chankrrn/WRO-FE-YBR-SUNFLOWER/v-photos/README.md

# Vehicle Photographs

This gallery will document the current vehicle from all required angles. **[TODO]** Add photographs of the completed redesigned vehicle and record the hardware revision/date so they match the engineering journal. Do not substitute Version 1.0 photographs for the new vehicle without labeling them.

## Standard views

| Front | Right | Rear |
|---|---|---|
| **[TODO]** Front-view photo | **[TODO]** Right-side photo | **[TODO]** Rear-view photo |

| Left | Top | Bottom |
|---|---|---|
| **[TODO]** Left-side photo | **[TODO]** Top-view photo | **[TODO]** Bottom-view photo |

## Additional views

| Right-front | Right-rear | Left-front | Left-rear |
|---|---|---|---|
| **[TODO]** Photo | **[TODO]** Photo | **[TODO]** Photo | **[TODO]** Photo |

## Components and construction details

- **[TODO]** Add annotated close-ups of the drivetrain, steering mechanism, electronics mounting, connectors, sensor mounts, and cable routing.
- **[TODO]** Provide a caption for each image: viewpoint, vehicle revision, date, and the design feature illustrated.

See the [Mobility and mechanical design](../journal/mech.md) and [Power and system architecture journal](../journal/elec.md) for component specifications, construction, and testing evidence.

[Back to project overview](../README.md)
