chankrrn/WRO-FE-YBR-SUNFLOWER/t-photos/README.md

# Team Photographs

Official YBR-SUNFLOWER team photograph

## Team and responsibilities

| Member | Primary responsibility | Supporting responsibilities |
|---|---|---|
| **Peradon Nimsongprasert (Tun)** | Robot construction and software development | Testing, debugging, and optimization |
| **Chanakarn Yimsakul (Indy)** | Engineering documentation and technical writing | Development records and software support |
| **Thanphisit Sakulvitulthai (Peach)** | Hardware development and electrical systems | Assembly, tests, and documentation |

## Photo collection

- **[TODO]** Add workshop, assembly, calibration, and testing photographs with dates and short captions.
- **[TODO]** Add updated team photos if needed, with filenames and appropriate credits.

[Back to project overview](../README.md)
