chankrrn/WRO-FE-YBR-SUNFLOWER/engineering_journal/visualization/16_motor_spec_points.png

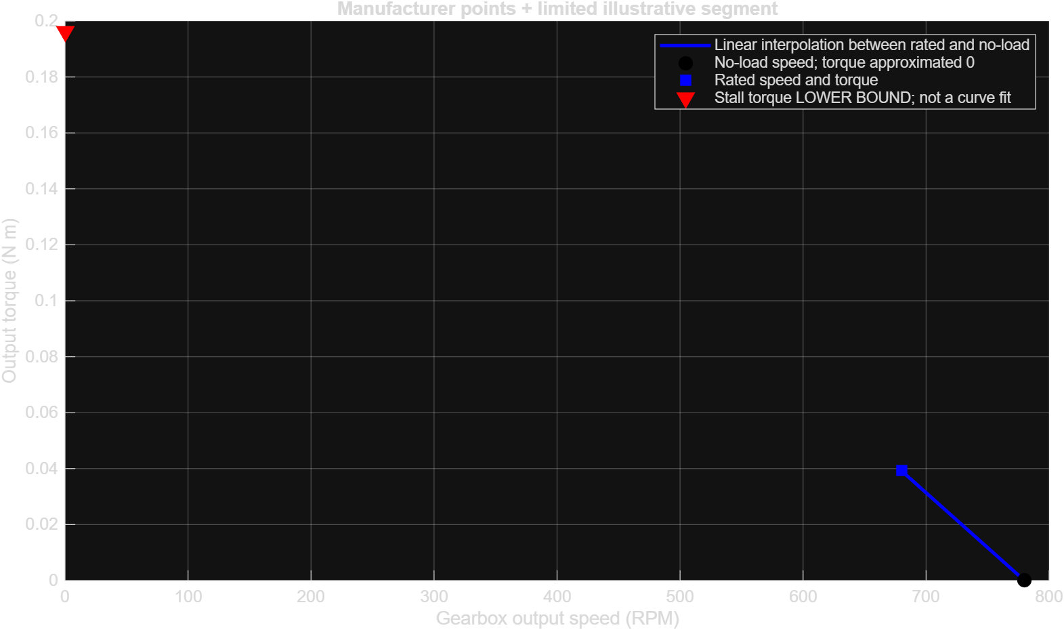
engineering_journal/visualization/16_motor_spec_points.png
