chankrrn/WRO-FE-YBR-SUNFLOWER/src/Raspberrypi/fov_check.png

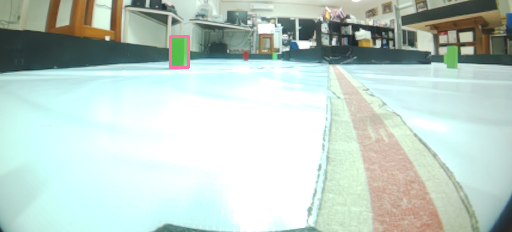
src/Raspberrypi/fov_check.png
