chankrrn/WRO-FE-YBR-SUNFLOWER/models/CAD/cam_plate.stl

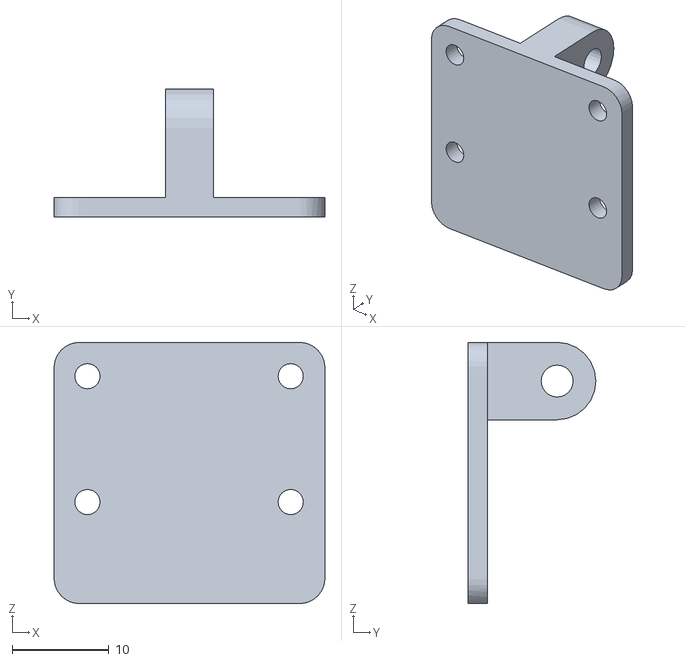
[picture p8: CAD file, 2026-11-12]
models/CAD/cam_plate.stl
28.0 x 13.2 x 27.0
