chankrrn/WRO-FE-YBR-SUNFLOWER/models/CAD/steering/steering_rack.stl

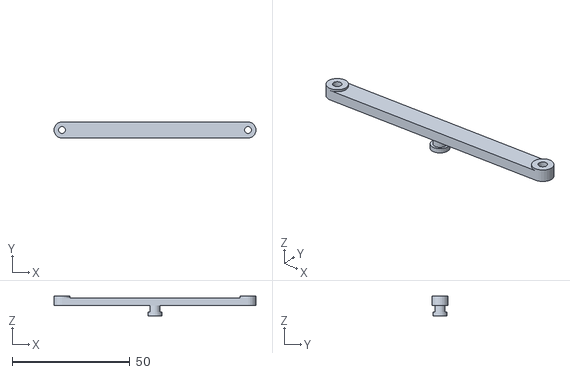
[picture p9: CAD file, 2026-11-12]
models/CAD/steering/steering_rack.stl
85.7 x 6.83 x 8.30
