chankrrn/WRO-FE-YBR-SUNFLOWER/models/CAD/servo_base.stl

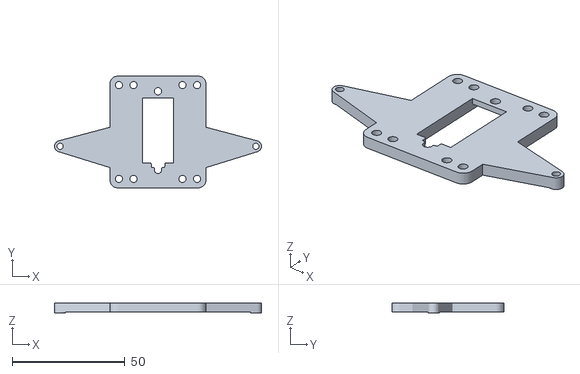
[picture p10: CAD file, 2026-11-12]
models/CAD/servo_base.stl
92.0 x 49.7 x 4.30
