chankrrn/WRO-FE-YBR-SUNFLOWER/models/CAD/Mid_axle_sleeve.stl

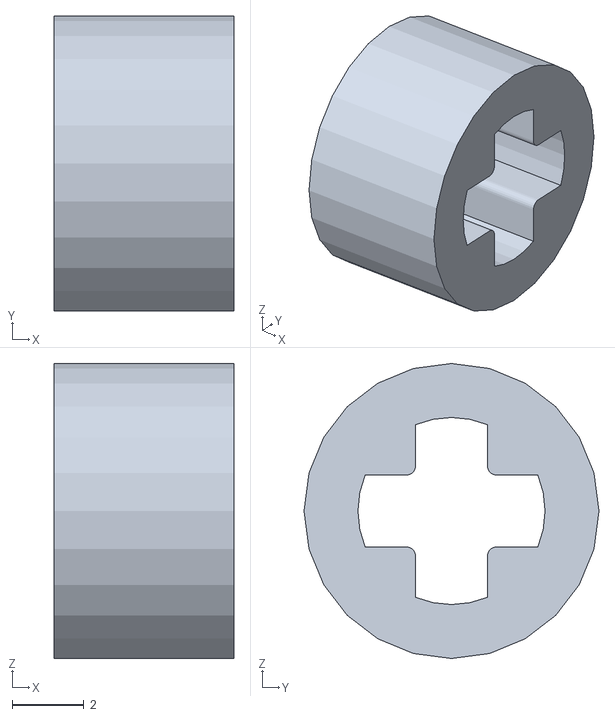
[picture p11: CAD file, 2026-11-12]
models/CAD/Mid_axle_sleeve.stl
5.00 x 8.20 x 8.20
