chankrrn/WRO-FE-YBR-SUNFLOWER/models/CAD/top_buck.stl

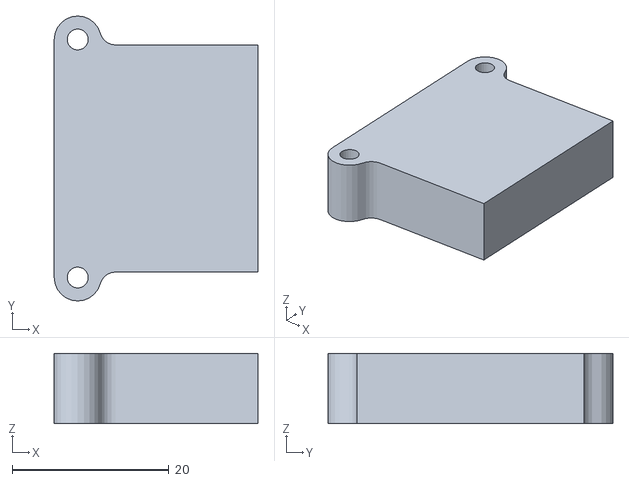
[picture p12: CAD file, 2026-11-12]
models/CAD/top_buck.stl
26.0 x 36.4 x 9.00
