chankrrn/WRO-FE-YBR-SUNFLOWER/models/CAD/elec_base.stl

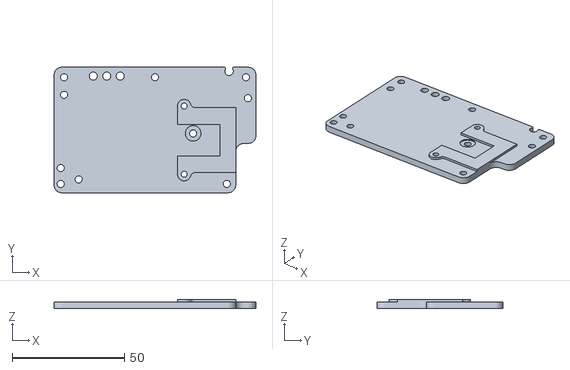
[picture p13: CAD file, 2026-11-12]
models/CAD/elec_base.stl
90.0 x 56.0 x 4.00
