chankrrn/WRO-FE-YBR-SUNFLOWER/models/CAD/cap.stl

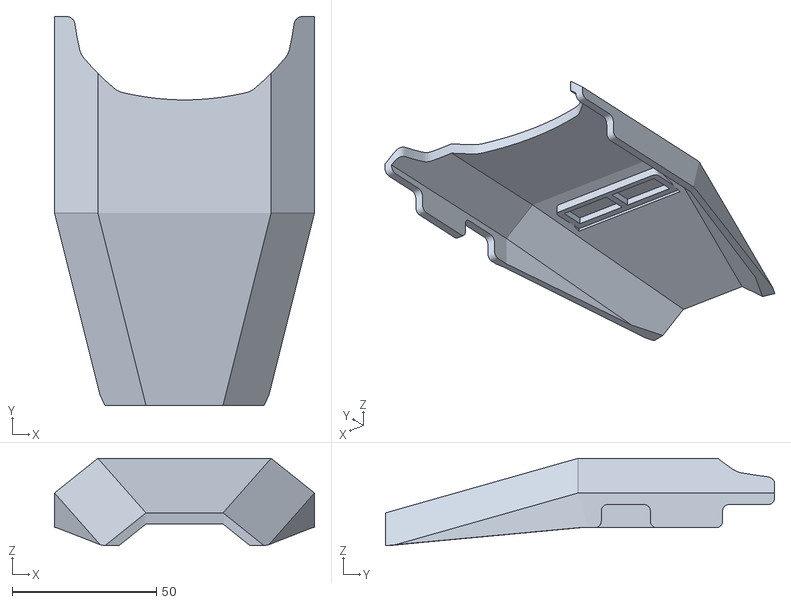
[picture p14: CAD file, 2026-11-12]
models/CAD/cap.stl
90.0 x 134.7 x 30.3
