chankrrn/WRO-FE-YBR-SUNFLOWER/models/CAD/IMU_plate.stl

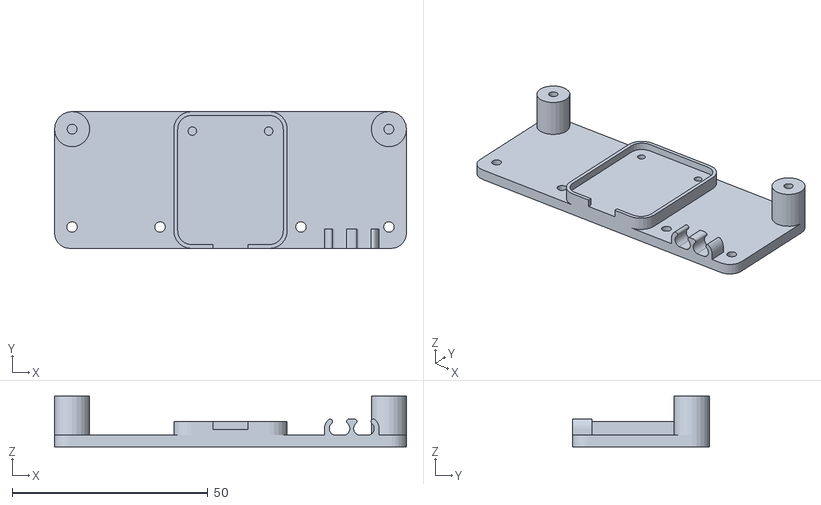
[picture p15: CAD file, 2026-11-12]
models/CAD/IMU_plate.stl
90.0 x 35.0 x 13.0
