chankrrn/WRO-FE-YBR-SUNFLOWER/(list of files, cad)

Other CAD files:
models/CAD/bottom_buck.stl
