chankrrn/WRO-FE-YBR-SUNFLOWER/history/README.md

# Competition Record 

## Our Team (Robot Version 1.0)

YBR-SUNFLOWER, representing **Yothinburana School**, placed **1st** in the **WRO Thailand 2026 Future Engineers National Final**, held on **3–4 September 2026**.

<p align="center">
  
</p>

## Senior Team

`2010 — First International Round Achievement`

Our team made its international debut at the World Robot Olympiad (WRO) in 2010, achieving 3rd place (Second Runner-Up).

<p align="center">
  
</p>

`2011 — Second International Round Achievement`

In our second appearance at the WRO international round in 2011, our team achieved 1st place (Champion), marking a significant milestone in our competition history.  

<p align="center">
  
</p>

`20XX — Latest International Round Achievement`

<p align="center">
  
</p>

Currently in 2026, we are part of the **YB Robot Team**. Our senior helped bring this team name to global recognition, and we aim to continue the legacy and make them proud.

<hr>
