chankrrn/WRO-FE-YBR-SUNFLOWER/engineering_journal/visualization/11_resistance_load_sweep.png

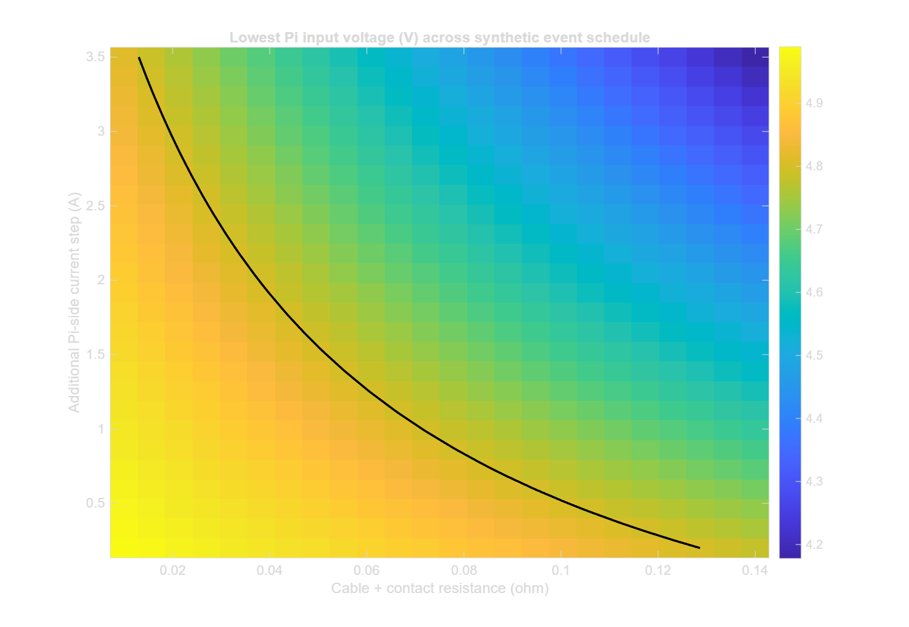
engineering_journal/visualization/11_resistance_load_sweep.png
