chankrrn/WRO-FE-YBR-SUNFLOWER/engineering_journal/visualization/12_turning_radius_vs_steering.png

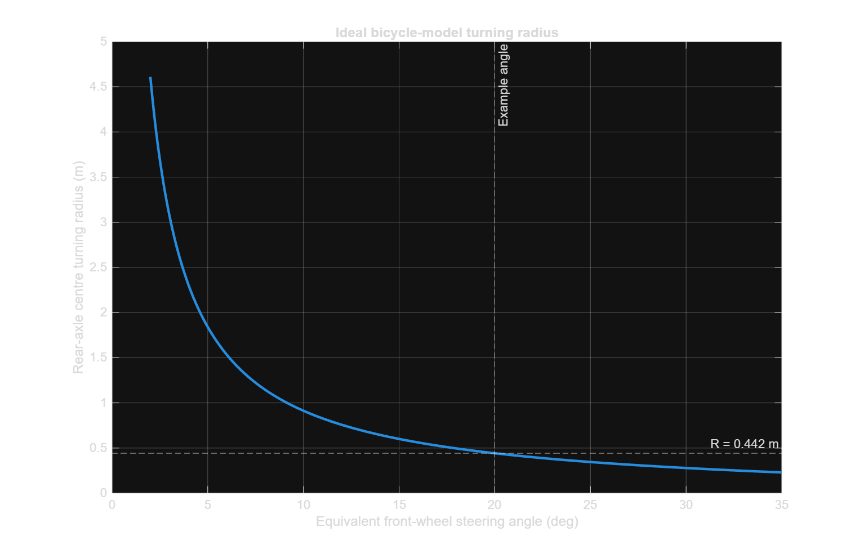
engineering_journal/visualization/12_turning_radius_vs_steering.png
