chankrrn/WRO-FE-YBR-SUNFLOWER/engineering_journal/visualization/25_cg_height_tipping_sensitivity.png

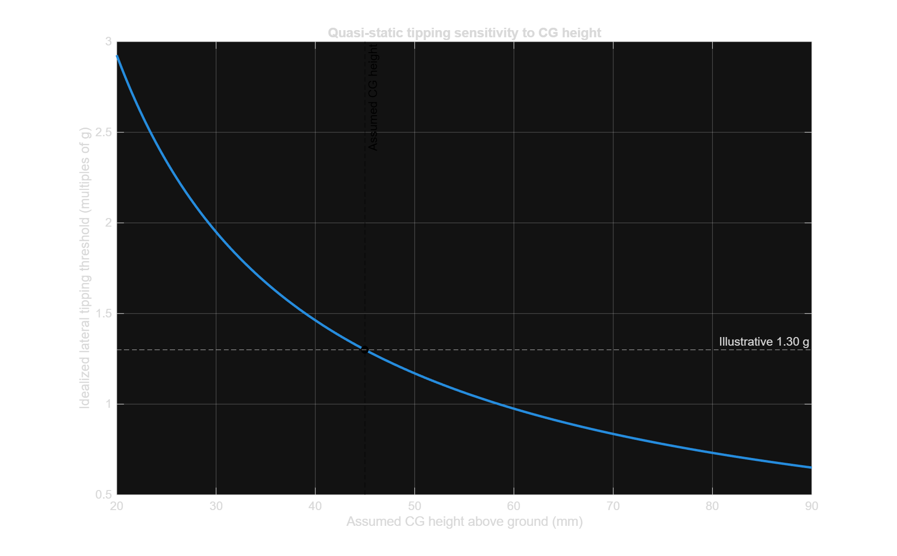
engineering_journal/visualization/25_cg_height_tipping_sensitivity.png
