chankrrn/WRO-FE-YBR-SUNFLOWER/history/ver01.jpg

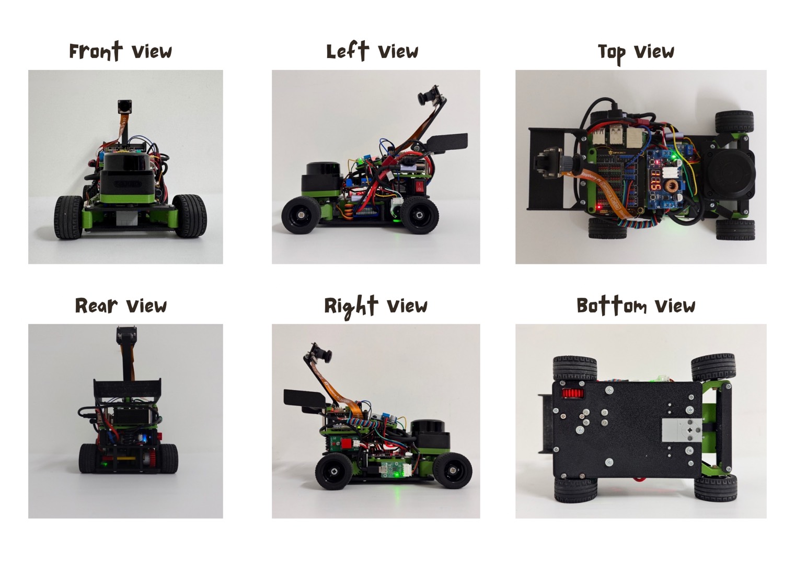
history/ver01.jpg
