chankrrn/WRO-FE-YBR-SUNFLOWER/journal/visualization/02_input_range_screen.png

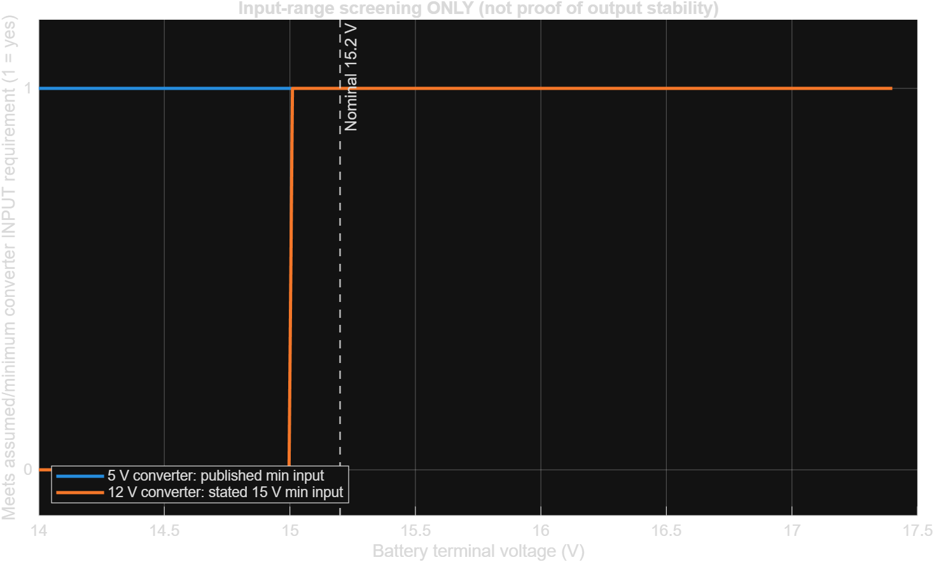
journal/visualization/02_input_range_screen.png
