chankrrn/WRO-FE-YBR-SUNFLOWER/journal/visualization/03_estimated_input_current.png

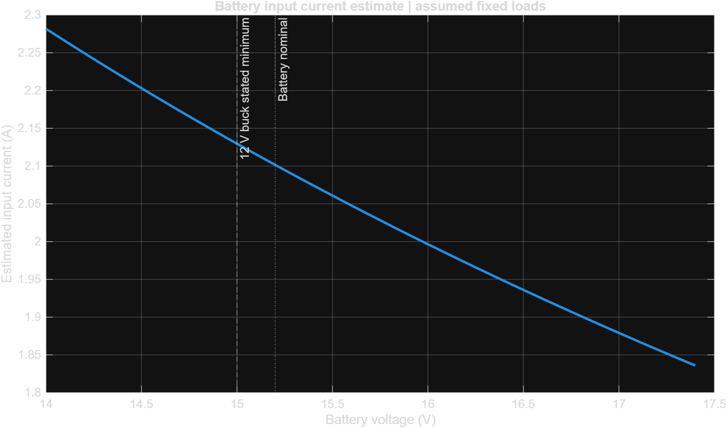
journal/visualization/03_estimated_input_current.png
