chankrrn/WRO-FE-YBR-SUNFLOWER/journal/visualization/04_assumed_voltage_vs_soc.png

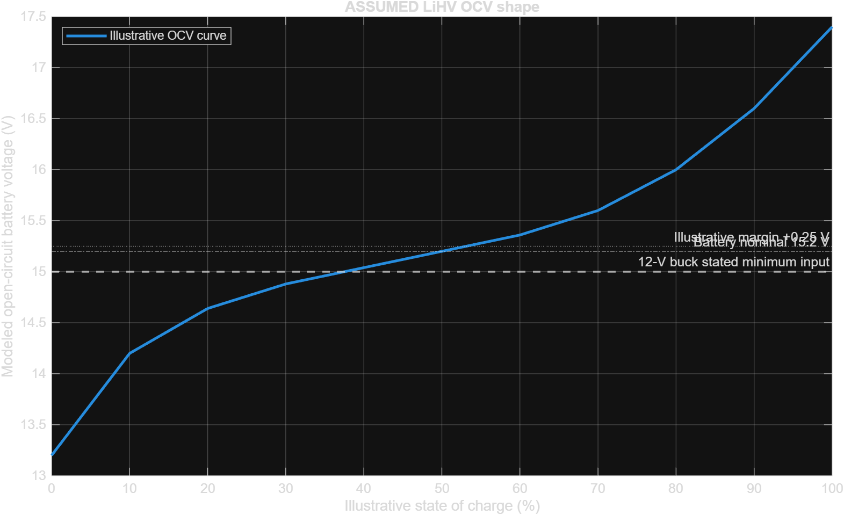
journal/visualization/04_assumed_voltage_vs_soc.png
