chankrrn/WRO-FE-YBR-SUNFLOWER/journal/visualization/05_voltage_vs_time_scenarios.png

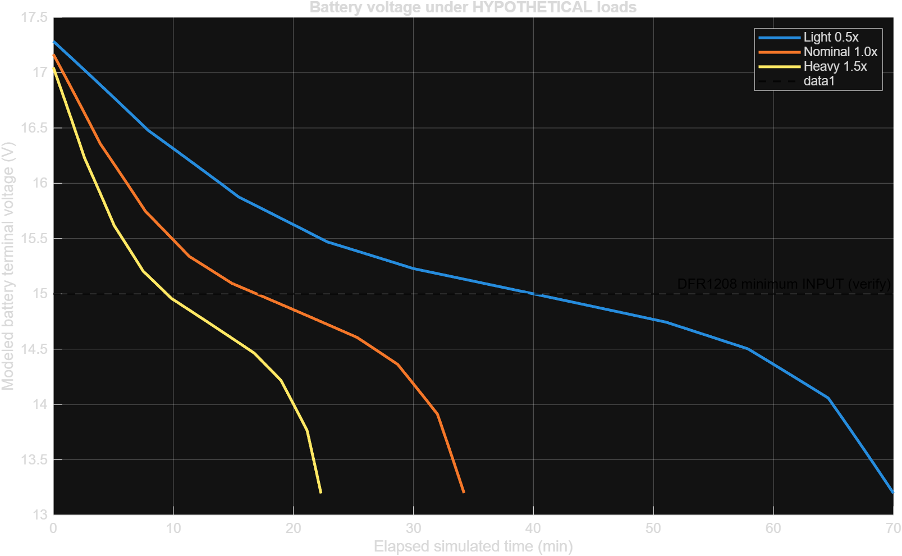
journal/visualization/05_voltage_vs_time_scenarios.png
