chankrrn/WRO-FE-YBR-SUNFLOWER/journal/visualization/06_soc_and_current.png

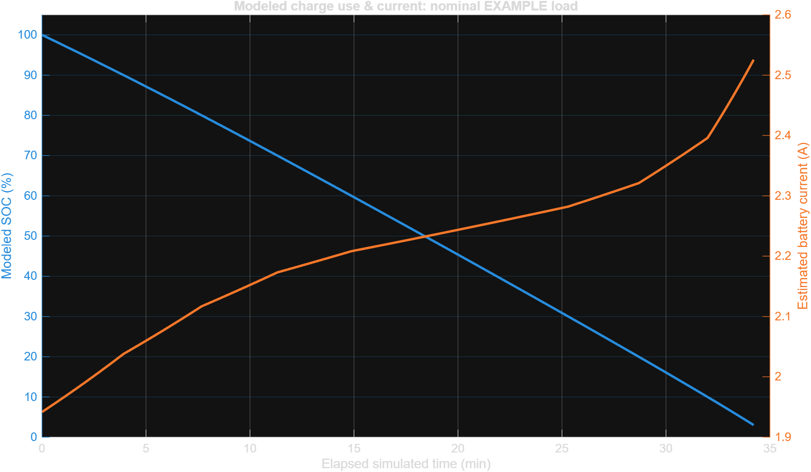
journal/visualization/06_soc_and_current.png
