chankrrn/WRO-FE-YBR-SUNFLOWER/journal/visualization/08_transient_timeline.png

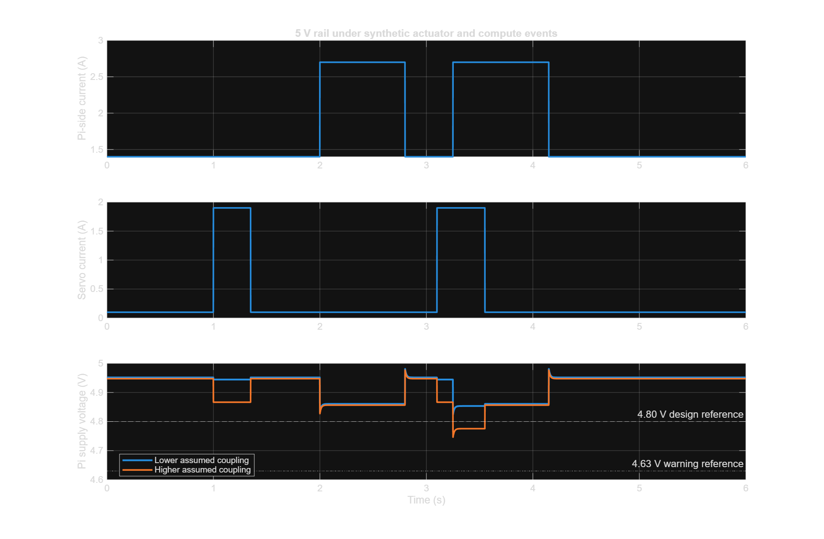
journal/visualization/08_transient_timeline.png
