chankrrn/WRO-FE-YBR-SUNFLOWER/journal/visualization/13_ackermann_angles.png

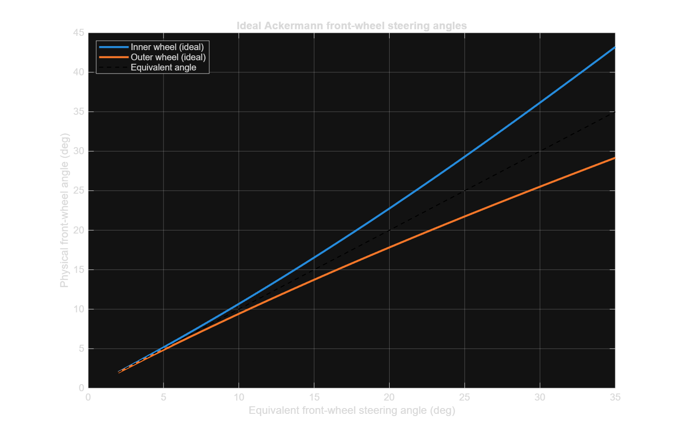
journal/visualization/13_ackermann_angles.png
