chankrrn/WRO-FE-YBR-SUNFLOWER/journal/visualization/14_ideal_wheel_paths.png

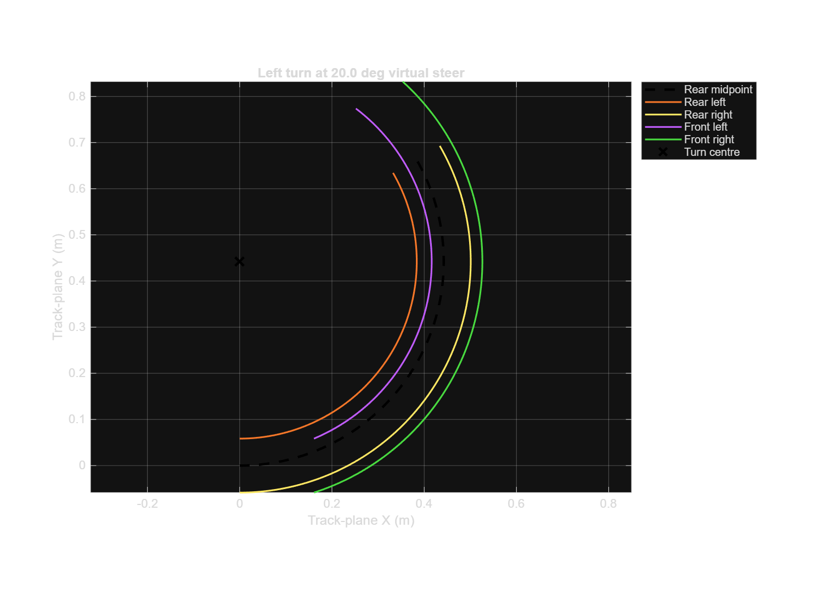
journal/visualization/14_ideal_wheel_paths.png
