chankrrn/WRO-FE-YBR-SUNFLOWER/journal/visualization/18_tractive_force_sensitivity.png

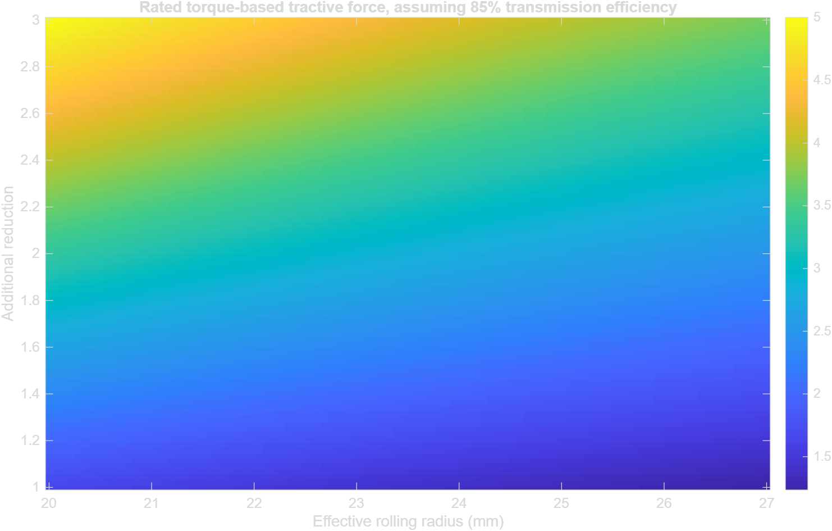
journal/visualization/18_tractive_force_sensitivity.png
