chankrrn/WRO-FE-YBR-SUNFLOWER/journal/visualization/20_shaft_and_wheel_response.png

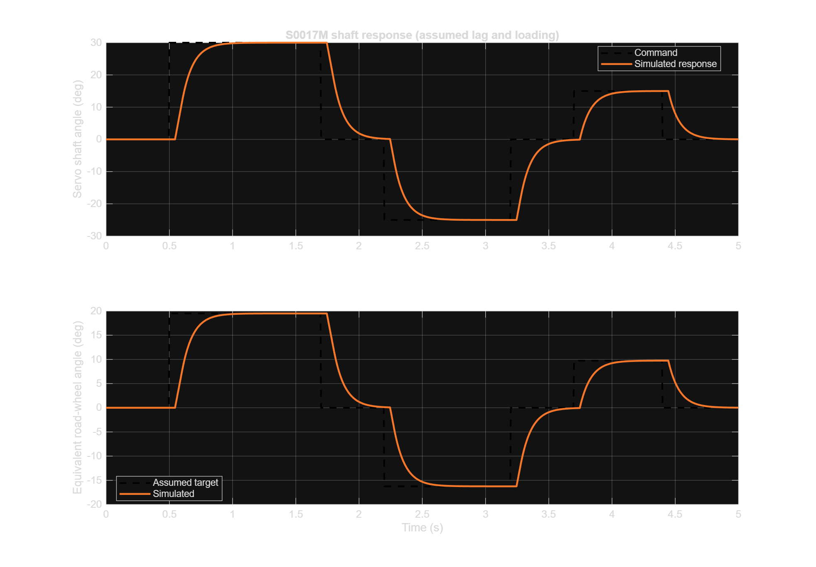
journal/visualization/20_shaft_and_wheel_response.png
