chankrrn/WRO-FE-YBR-SUNFLOWER/journal/visualization/21_scenario_comparison.png

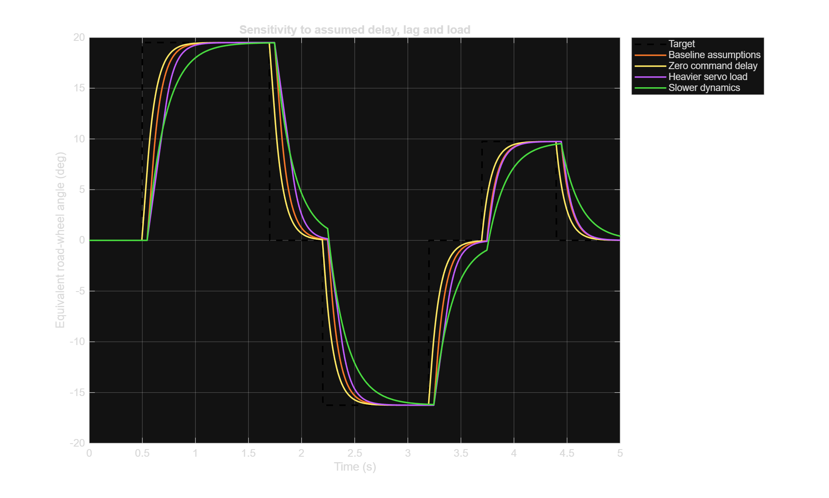
journal/visualization/21_scenario_comparison.png
