chankrrn/WRO-FE-YBR-SUNFLOWER/journal/visualization/22_steering_error.png

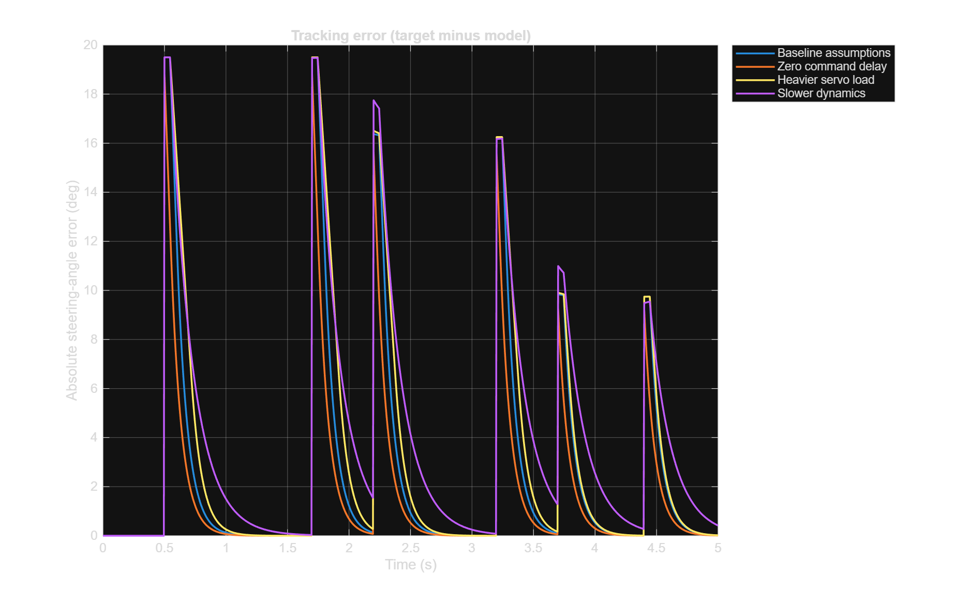
journal/visualization/22_steering_error.png
