chankrrn/WRO-FE-YBR-SUNFLOWER/journal/visualization/23_yaw_rate_effect.png

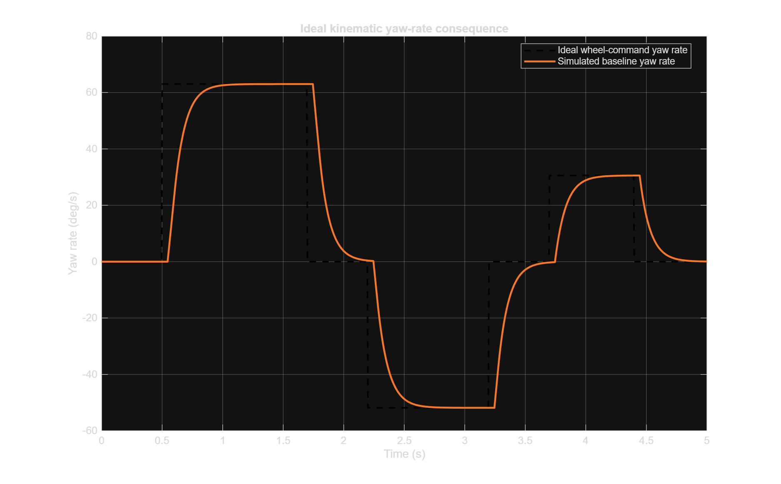
journal/visualization/23_yaw_rate_effect.png
