chankrrn/WRO-FE-YBR-SUNFLOWER/journal/visualization/24_axle_load_distribution.png

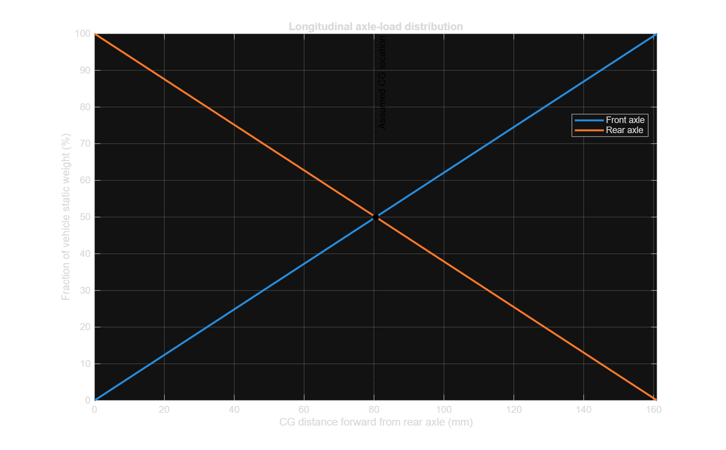
journal/visualization/24_axle_load_distribution.png
