chankrrn/WRO-FE-YBR-SUNFLOWER/journal/visualization/26_swept_body_paths.png

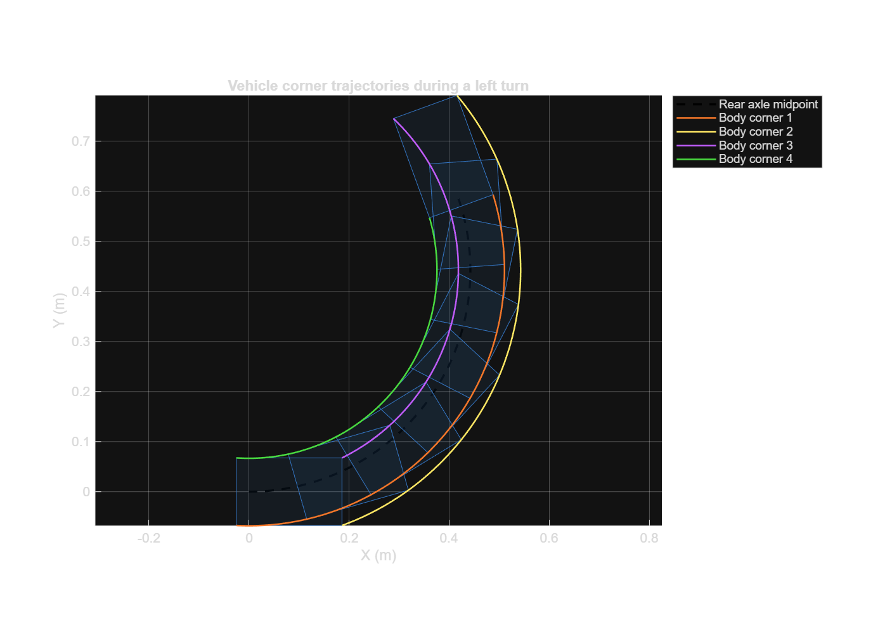
journal/visualization/26_swept_body_paths.png
