chankrrn/WRO-FE-YBR-SUNFLOWER/journal/visualization/27_turn_envelope_vs_steering.png

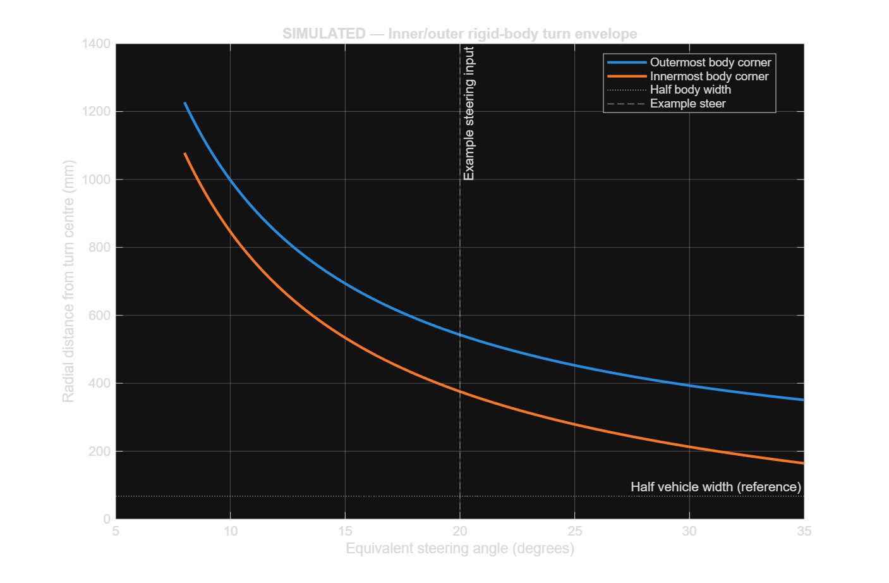
journal/visualization/27_turn_envelope_vs_steering.png
