chankrrn/WRO-FE-YBR-SUNFLOWER/journal/visualization/29_pure_pursuit_tracking.png

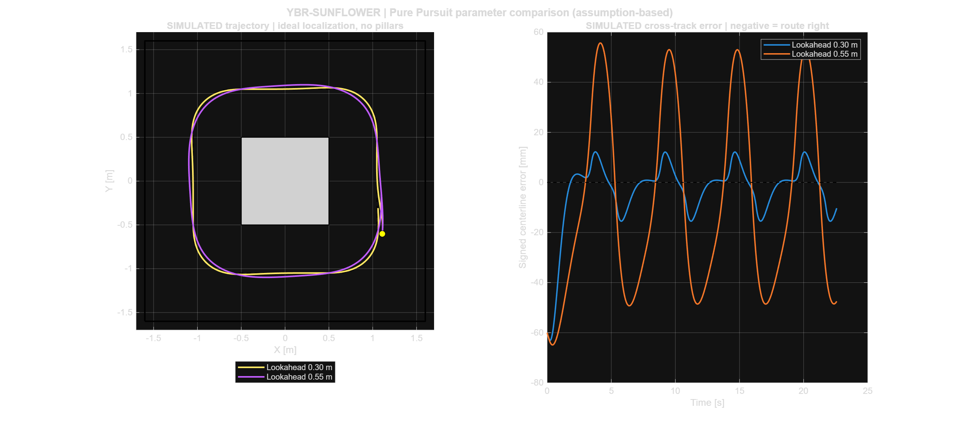
journal/visualization/29_pure_pursuit_tracking.png
