chankrrn/WRO-FE-YBR-SUNFLOWER/schemes/schematic_diagram.pdf

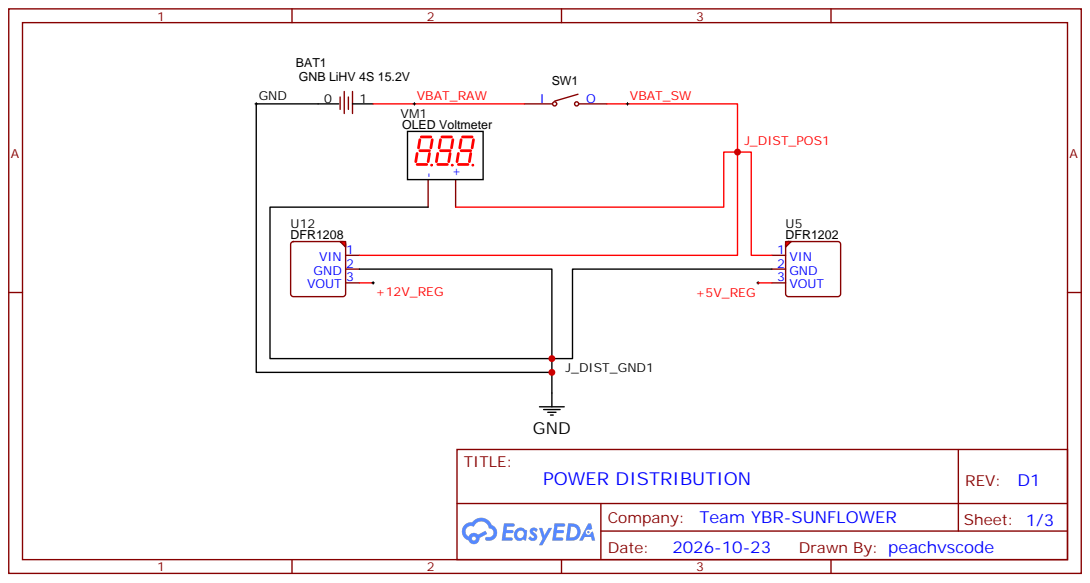
[picture p74: page 1]

Company: Team YBR-SUNFLOWER

A | A
B | B
C | C

### TITLE:

MAIN CONTROLLER & HAT INTERFACES | REV: D1
| Sheet: 2/3

## Company: Team YBR-SUNFLOWER

U2 DFR0592 DC Motor Driver HAT

I2C_SDA 1

I2C_SCL 2

HAT_5V 3

GND 4

VM_12V 5

VM_GND 6

M1- 7

M1+ 8

E1B 9

E1A 10

E1- 11

E1+ 12

U3 | DFR0604 IO Expansion HAT

I2C_SDA 1

I2C_SCL 2

HAT_5V 3

GND 4

GPIO16 5

UART_TX 6

UART_RX 7

SERVO_VP 8

IIC_D 9

IIC_C 10

IIC_+ 11

IIC_- 12

D16_D 13

D16_+ 14

D16_- 15

PWM3_P 16

PWM3_+ 17

PWM3_- 18

UART_R 19

UART_T 20

UART_- 21

RPI1 | Raspberry Pi 5
3.3V 1 | 5V 2
GPIO2 3 | 5V 4
GPIO3 5 | GND 6
GPIO4 7 | GPIO14 8
GND 9 | GPIO15 10
GPIO17 11 | GPIO18 12
GPIO27 13 | GND 14
GPIO22 15 | GPIO23 16
3.3V 17 | GPIO24 18
GPIO10 19 | GND 20
GPIO9 21 | GPIO25 22
GPIO11 23 | GPIO8 24
GND 25 | GPIO7 26
GPIO0 27 | GPIO1 28
GPIO5 29 | GND 30
GPIO6 31 | GPIO12 32
GPIO13 33 | GND 34
GPIO19 35 | GPIO16 36
GPIO26 37 | GPIO20 38
GND 39 | GPIO21 40

I2C_SCL

I2C_SCL

I2C_SDA

I2C_SDA

I2C_SCL

GND

+12V_REG

External motor supply: 12 V nominal

I2C_SDA

I2C_SCL

BTN_D16

BTN_D16

BTN_D16

PI_UART_TX

PI_UART_TX

PI_UART_TX

PI_UART_RX

PI_UART_RX
PI_UART_RX

PI_3V3

PI_3V3

PI_3V3

PI_3V3

PWM_STEER

SERVO_V+

GND

MOTOR_M1_NEG

MOTOR_M1_POS

ENC_E1B

ENC_E1A

ENC_E1_GND

ENC_E1_VCC

I2C_SDA

PI_5V
PI_5V
GND

GND

PI_5V

PI_5V

GND

GND

GND

GND

DC MOTOR & ENCODER | STEERING SERVO & USER INTERFACE

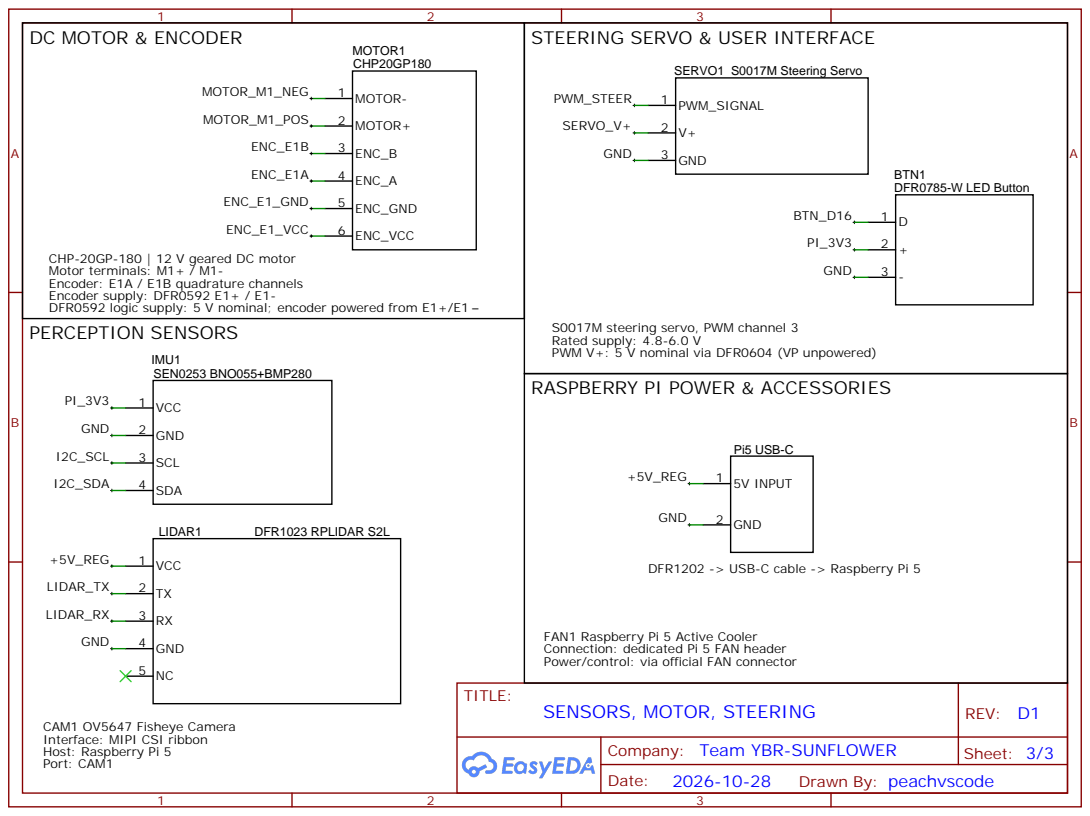
[picture p75: page 3]

CHP-20GP-180 | 12 V geared DC motor
Motor terminals: M1+ / M1-
Encoder: E1A / E1B quadrature channels
Encoder supply: DFR0592 E1+ / E1-
DFR0592 logic supply: 5 V nominal; encoder powered from E1+/E1
PERCEPTION SENSORS

S0017M steering servo, PWM channel 3
Rated supply: 4.8-6.0 V
PWM V+: 5 V nominal via DFR0604 (VP unpowered)
RASPBERRY PI POWER & ACCESSORIES

DFR1202 -> USB-C cable -> Raspberry Pi 5

FAN1 Raspberry Pi 5 Active Cooler
Connection: dedicated Pi 5 FAN header
Power/control: via official FAN connector

CAM1 OV5647 Fisheye Camera
Interface: MIPI CSI ribbon
Host: Raspberry Pi 5
Port: CAM1

Company: Team YBR-SUNFLOWER
