chankrrn/WRO-FE-YBR-SUNFLOWER/src/Raspberrypi/camera_manager.py

try:
    from picamera2 import Picamera2
except ImportError as exc:
    # The stub only exists so hsv_adjuster can be run off-Pi. On the Pi this
    # branch means the interpreter cannot see the system picamera2 - almost
    # always a venv built without --system-site-packages - and every frame
    # would silently come back empty. Say so instead of failing later with an
    # unrelated AttributeError deep inside configure_camera().
    print(f"WARNING: picamera2 unavailable ({exc}); falling back to the "
          f"fake_picamera2 stub - NO real frames will be captured.")
    from utils.fake_picamera2 import Picamera2
import time
from utils.image_transform_utils import ImageTransformUtils
from utils.image_transform_utils import ImageColorUtils
import cv2
import numpy as np
from utils.enums import Color
from utils.image_drawing_utils import ImageDrawingUtils
import math
import os
from utils.video.video_counter import VideoCounter
from classes.image_algoriths import ImageAlgorithms
from classes.context_manager import ContextManager

# Auto-exposure stays ON; this only shifts the brightness it aims for, in
# stops (-8.0 .. 8.0, 0.0 = libcamera's default, +1.0 = twice as bright).
# Brighter frames move every colour's HSV value up, so re-check the
# thresholds in utils/image_color_utils.py after changing it.
EXPOSURE_EV = 0.6

class CameraManager:

    def __init__(self, record_video=False, record_fps=15.0):
        """
        I/O:
            record_video: write every frame the round sees to videos/videoN.mp4.
                          Off by default because it costs a full-frame copy per
                          frame - the display image the writer needs is
                          otherwise only taken when something is going to draw
                          on it.
            record_fps:   the rate frames will actually ARRIVE at, which is the
                          vision thread's, not the camera's.
        """
        self.record_video = bool(record_video)
        self.record_fps = float(record_fps)
        self.video_output = None
        self.previous_time = 0

        self.picam2 = Picamera2()
        self.raw_image = None
        self.cropped_image = None
        self.colormask_image = None
        
        self.blue_mask = None
        self.orange_mask = None
        self.green_mask = None
        self.red_mask = None
        self.pink_mask = None
        self.blueline_image = None
        self.orangeline_image = None
        self.clean_blueline_image = None
        self.clean_orangeline_image = None
        self.cnt_blueline = None    # to delete and change place
        self.cnt_orangeline = None  # to delete and change place
        self.length_blue = None      # to delete and change place
        self.length_orange = None    # to delete and change place
        self.grayscale_image = None
        self.blurred_image = None
        self.binary_image = None
        self.clean_image = None
        self.polygon_image = None
        self.polygon_lines = None
        self.combined_mask = None
        self.with_pink_combined_mask = None
        self.grayscale_image = None
        self.binary_obstacle = None
        self.obstacle_image = None
        self.pink_obstacle_image = None
        self.contour_obstacle = None
        self.pink_image = None
        
        self.hsv_image = None

        # the image used to display all the relevant info
        self.display_image = None

        self.configure_camera()

    def configure_camera(self):
        sensor_mode = self.picam2.sensor_modes[1]
        sensor_width, sensor_height = sensor_mode["size"]
        # A VIDEO configuration, not a still one. A still config allocates a
        # single buffer and runs the ISP in its highest-quality mode, so every
        # capture_array() waits out a whole frame with nothing queued behind
        # it - which is exactly the wrong trade for a stream of frames that
        # only ever gets thresholded into colour masks.
        #
        # The raw size stays pinned to sensor_modes[1]. That is what fixes the
        # sensor mode, and the sensor mode is what ObjectSolver's measured
        # CAPTURED_HORIZONTAL_FOV_DEG describes - let libcamera pick its own
        # and every distance the pillar solver reports is quietly wrong.
        config = (self.picam2.create_video_configuration(
        raw={"size":(sensor_width,sensor_height)},
        main={"format":'RGB888',"size": (ImageTransformUtils.CAMERA_PIC_WIDTH, ImageTransformUtils.CAMERA_PIC_HEIGHT)},
        controls={"ExposureValue": EXPOSURE_EV},
        buffer_count=4))
        self.picam2.configure(config)
        
        if self.record_video:
            self.configure_video_output()

    def configure_video_output(self):
        output_folder = os.path.join(os.path.dirname(__file__), "../videos")
        os.makedirs(output_folder, exist_ok=True)
        
        output_path = os.path.join(output_folder, f"video{VideoCounter.get_video_counter()}.mp4")
        
        fourcc = cv2.VideoWriter_fourcc(*'mp4v')
        # THE FPS HAS TO MATCH THE LOOP THAT FEEDS IT. Frames arrive at the
        # vision thread's rate, not at 25/s, and a writer told the wrong
        # number does not drop or duplicate anything - it just stamps the
        # frames with the wrong timebase, so the whole round plays back at the
        # wrong speed. 15 in, 25 declared, is a video that runs 1.7x fast.
        self.video_output = cv2.VideoWriter(
            output_path, fourcc, float(self.record_fps),
            (ImageTransformUtils.PIC_WIDTH, ImageTransformUtils.PIC_HEIGHT))
        if not self.video_output.isOpened():
            print(f"WARNING: could not open {output_path} for writing - the run "
                  f"will not be recorded")
            self.video_output = None
            return
        print(f"Recording to {output_path} at {self.record_fps:.0f}fps")
        VideoCounter.increment_video_counter()
        
    def start_camera(self):
        self.picam2.start()
        time.sleep(2)

    def capture_image(self):
        if self.raw_image is not None:
            del self.raw_image
        self.raw_image = self.picam2.capture_array()
        if self.previous_time != 0:
            pass
            #print(f"Delay between frames: {time.time() - self.previous_time:.3f} seconds")
        self.previous_time = time.time()
        
    def capture_for_blocks(self, with_display=False):
        """
        Everything ObjectSolver needs from a frame, and nothing else.

        transform_image() builds the whole vision pipeline: the grayscale /
        binary / polygon stack, the blue and orange line rectangles, the pink
        and obstacle masks. The obstacle round reads exactly two of its
        products - hsv_image, and display_image only when something is going
        to draw on it - so it spends most of a frame computing answers no
        caller ever asks for.

        Measured on a Pi 5 against a 640x280 mat frame, OpenCV single
        threaded:

            transform_image()          19.6 ms
            this                        0.8 ms

        That difference is not academic: at CAMERA_EVERY_N_TICKS the round was
        paying it on every other 20ms control tick.

        I/O:
            with_display: also keep a BGR copy for ObjectSolver to draw its
                          overlay on. Costs a full-frame copy, so leave it off
                          unless the overlay is actually going to be looked at.
            return: the HSV frame, or None if there was nothing to capture
        """
        self.capture_image()
        if self.raw_image is None:
            return None

        # A view, not a copy - bgr_to_hsv allocates its own output and the
        # display copy is taken explicitly, so nothing here aliases the next
        # frame's buffer.
        self.cropped_image = ImageTransformUtils.crop_image(
            self.raw_image, ImageTransformUtils.PIC_X_START,
            ImageTransformUtils.PIC_X_START + ImageTransformUtils.PIC_WIDTH,
            ImageTransformUtils.PIC_Y_START,
            ImageTransformUtils.PIC_Y_START + ImageTransformUtils.PIC_HEIGHT)
        self.display_image = self.cropped_image.copy() if with_display else None
        self.hsv_image = ImageTransformUtils.bgr_to_hsv(self.cropped_image)
        return self.hsv_image

    def add_frame_to_video(self, frame=None):
        if self.display_image is None and frame is None:
            return
        if frame is None:
            frame = self.display_image
        if frame.shape[1] != ImageTransformUtils.PIC_WIDTH or frame.shape[0] != ImageTransformUtils.PIC_HEIGHT:
            print(f"Frame size does not match video output size. Expected ({ImageTransformUtils.PIC_WIDTH}, {ImageTransformUtils.PIC_HEIGHT}), got {self.display_image.shape[1]}x{self.display_image.shape[0]}.")
            return
         # Ensure the image has 3 channels
        if len(frame.shape) == 2: # grayscale or binary image
            frame = cv2.cvtColor(self.display_image, cv2.COLOR_GRAY2RGB)
        #print(f"Adding frame to video")
        if self.video_output is not None and self.video_output.isOpened():
            self.video_output.write(frame)
    
    def release_video(self):
        """Release the video writer to finalize the video file"""
        if self.video_output is not None:
            print("Releasing video writer...")
            self.video_output.release()
            self.video_output = None
            print("Video recording finalized and saved")

    def transform_image(self):
        if self.raw_image is not None:
            self.cropped_image = ImageTransformUtils.crop_image(self.raw_image, ImageTransformUtils.PIC_X_START, ImageTransformUtils.PIC_X_START + ImageTransformUtils.PIC_WIDTH, ImageTransformUtils.PIC_Y_START, ImageTransformUtils.PIC_Y_START + ImageTransformUtils.PIC_HEIGHT)
            self.display_image = self.cropped_image.copy()
            
            self.hsv_image = ImageTransformUtils.bgr_to_hsv(self.cropped_image.copy())
            self.colormask_image,_ = ImageTransformUtils.remove_color(self.hsv_image.copy(), self.cropped_image.copy(), Color.ALL_COLORS)
            self.grayscale_image = ImageTransformUtils.color_to_grayscale(self.colormask_image)
            self.blurred_image = ImageTransformUtils.blur_image(self.grayscale_image)
            self.binary_image = ImageTransformUtils.make_binary(self.blurred_image)
            self.clean_image = ImageTransformUtils.clean_binary(self.binary_image)
            
            self.blue_mask = ImageColorUtils.calculate_color_mask(self.hsv_image, Color.BLUE)
            self.orange_mask = ImageColorUtils.calculate_color_mask(self.hsv_image, Color.ORANGE)
            self.green_mask = ImageColorUtils.calculate_color_mask(self.hsv_image, Color.GREEN)
            self.red_mask = ImageColorUtils.calculate_color_mask(self.hsv_image, Color.RED)
            self.pink_mask = ImageColorUtils.calculate_color_mask(self.hsv_image, Color.PINK)

            self.polygon_image, self.polygon_lines = ImageDrawingUtils.draw_polygon(self.clean_image, self.clean_image)
            self.blueline_image = ImageTransformUtils.keep_color(self.hsv_image, Color.BLUE)
            self.orangeline_image = ImageTransformUtils.keep_color(self.hsv_image, Color.ORANGE)
            self.clean_blueline_image = cv2.bitwise_and(self.blueline_image, self.blueline_image, mask = self.polygon_image)
            self.clean_orangeline_image = cv2.bitwise_and(self.orangeline_image, self.orangeline_image, mask = self.polygon_image)
            self.cnt_blueline, self.length_blue, _, _ = ImageDrawingUtils.find_rect(self.clean_blueline_image)
            self.cnt_orangeline, self.length_orange, _, _ = ImageDrawingUtils.find_rect(self.clean_orangeline_image)

            #self.pink_image = cv2.bitwise_and(self.polygon_image, self.polygon_image, mask = self.pink_mask)
            self.combined_mask = cv2.bitwise_or(ImageTransformUtils.keep_color(self.hsv_image.copy(), Color.GREEN), ImageTransformUtils.keep_color(self.hsv_image.copy(), Color.RED))
            self.obstacle_image = cv2.bitwise_and(self.polygon_image, self.polygon_image, mask = self.combined_mask)
            
            #self.binary_obstacle = cv2.bitwise_and(self.cropped_image.copy(), self.cropped_image.copy(), mask = self.combined_mask)
            #self.grayscale_image = ImageUtils.color_to_grayscale(self.binary_obstacle)
            #self.obstacle_image = ImageUtils.make_binary(self.grayscale_image)
            ##self.obstacle_image = ImageUtils.dilate(self.obstacle_image)
            ImageDrawingUtils.find_rect(self.pink_mask.copy(), self.polygon_image.copy(), self.display_image)
            # Pillars (red OR green - this mask doesn't know which) in yellow,
            # so they can't be mistaken for the pink box drawn just above.
            ImageDrawingUtils.find_rect(self.obstacle_image.copy(), self.polygon_image.copy(), self.display_image, box_color=(0, 255, 255))
    
    def draw_arc(self, image, servo_angle):# Define arc parameters
 
        # Parameters
        wheelbase = .165  # m
        steering_angle_deg = servo_angle  # degrees
        steering_angle_rad = math.radians(steering_angle_deg)
        path_length = .3 # m

        # Calculate turning radius
        R = wheelbase / math.tan(steering_angle_rad)

        # Generate arc points in world coordinates
        points_world = []
        for d in np.linspace(0, path_length, num=50):
            x = R * math.sin(d / R)
            y = R * (1 - math.cos(d / R))
            points_world.append([x, y])
            print(x,y)

        points_world = np.array(points_world)

        # Simplified projection: scale and shift to image coordinates
        # These values depend on your camera setup
        scale = 1000  # pixels per meter
        if servo_angle < 0: 
            offset_x, offset_y = 320, 400  # image center or bottom center

        else:
            offset_x, offset_y = 320, 400  # image center or bottom center

        # Rotate to match image orientation (forward = up)
        points_world_rotated = np.array([[-p[1], p[0]] for p in points_world])

        # Project to image coordinates
        points_image = np.array([
                [int(offset_x + p[0]*scale), int(offset_y - p[1]*scale)]
        for p in points_world_rotated])

        # Draw path
        cv2.polylines(image, [points_image], isClosed=False, color=(0, 255, 0), thickness=2)

        cv2.imshow("Projected Path", image)



if __name__ == "__main__":
    camera_manager = CameraManager()
    context_manager = ContextManager()
    image_algorithms = ImageAlgorithms(context_manager, camera_manager)
    camera_manager.start_camera()
    while True:
        camera_manager.capture_image()
        camera_manager.transform_image()

        parking_quality = image_algorithms.verify_parking_quality()

        cv2.imshow("test", camera_manager.obstacle_image)
        cv2.imshow("cropped_image", camera_manager.cropped_image)
        cv2.imshow("pink", camera_manager.pink_mask)
        cv2.imshow("display", camera_manager.display_image)

        time.sleep(0.01)
        key = cv2.waitKey(1)  # Let OpenCV update the window
        if key == 27:  # Escape key to quit
            break
