chankrrn/WRO-FE-YBR-SUNFLOWER/src/Raspberrypi/classes/goal_planner.py

"""
Goal-based planning: pick poses the robot must reach, then plan a drivable
path through them.

This replaces the offset-profile approach the final round used to drive, where
a pillar bent the racing line sideways by a computed number of millimetres and
pure pursuit followed the bent line. That worked until the corridor ran out of
room, at which point the offset was silently clamped to whatever fitted and
the robot drove past the pillar at whatever clearance was left over - which on
a 1000mm corridor with a 525mm demand was, for a pillar on the same side as
its own dodge, none at all. The failure was invisible: nothing in the loop
knew the difference between "planned to pass at 300mm" and "asked for 525mm,
got 25mm, drove it anyway".

The model here is the ordinary one:

    GOAL      a pose - x, y AND heading - that the robot has to reach.
              Beside each pillar, on the side its colour dictates, squared up
              with the track. Plus plain route goals round the rest of the lap
              so there is always something ahead to drive at.

    PATH      the shortest curvature-bounded path through those goals in
              order, chained pose to pose with Dubins (classes/dubins.py).
              Curvature-bounded means every arc in it is one the steering can
              actually hold - a goal the robot cannot reach is rejected here,
              not discovered halfway through the corner.

    CHECK     the path is swept with the robot's own footprint against the
              pillars, the walls, the centre block and the parking bay. A
              path that collides is not driven; the goal that produced it is
              retried further out, and if nothing fits the plan says so.

    FOLLOW    pure pursuit chases a point one lookahead along the result,
              exactly as it chases the racing line in qualification. The
              follower did not need changing and has not been changed.

The property that matters, and the reason for the rewrite: a goal that cannot
be met is REPORTED. `Plan.compromised` and `Plan.reason` say which pillar could
not be given its clearance and how much it actually got, so a pass that is
going to be tight shows up in the status line on the approach instead of as a
collision nobody can explain afterwards.

    planner = GoalPlanner(field_map, racing_line, min_radius_mm=250)
    plan = planner.plan(pose, direction, pillars)
    target = plan.target_point(pose, lookahead_mm=300)

Everything is millimetres and the field frame from field_map.py; headings are
degrees clockwise from +Y.
"""
import math
import time
from collections import namedtuple

import numpy as np

from classes.dubins import dubins_cost, plan_dubins

# A pillar as the planner wants it: where it is and which way it must be
# passed. Deliberately not BlockMap's own type - the planner should not care
# how a pillar came to be believed in, only where it is.
Obstacle = namedtuple("Obstacle", "x y side")

# One goal pose in the chain, and why it exists. `obstacle` is None for the
# plain route goals that carry the plan round the rest of the lap.
# `kind` is what the goal is FOR - "route", "align", "pass" or "exit". Carried
# rather than worked out from the order by whoever is reading it: a pillar
# contributes two goals or three depending on align_mm, and a pass can be moved
# back along the lap (PASS_SHIFTS_MM) until it sits where its align would.
Goal = namedtuple("Goal", "x y heading obstacle clearance_mm progress offset "
                          "fallbacks kind")

# A goal before it becomes a pose: where along the lap it sits, how far to the
# right of the racing line, and how hard it is to argue with. `rank` is what
# _thin consults when two nodes are too close together to both be reached.
_Node = namedtuple("_Node", "progress offset rank obstacle clearance fallbacks")
_ROUTE = 0      # keeps the plan near the racing line - always expendable
_GATE = 1       # a pillar's pass or exit - the reason the plan exists
_ROBOT = 2      # where the robot actually is - not negotiable

# How much more room than the bare S-curve geometry needs is demanded before
# two nodes are accepted as reachable. At exactly 1.0 the connecting path is
# two arcs at full lock with no straight between them and nothing in hand for
# tracking error, which the follower cannot hold; the margin buys the slack
# back. Raise it if the plan still asks for more lock than the robot has.
SPAN_MARGIN = 1.35

# A path that turns through more than this in total is doing a loop: Dubins
# answers an unreachable goal with the shortest path that exists, and where
# the goal is too close or too far off to the side, the shortest thing that
# exists is a circle. Nothing legitimate on this track turns further - the
# sharpest thing the plan ever contains is a 90-degree corner and a pass
# either side of it - so this is a clean test for "that goal cannot be met
# from here". See _chain.
#
# 200, not the 270 this was first set to. 270 is inside the failure it is
# meant to exclude: a goal a hundred-odd mm ahead needs most of a circle to
# reach, and measured over 3000 random layouts every such path came out
# between 255 and 270 - under the gate, so accepted, and then PREFERRED,
# because a circle sweeps wide of the pillars and therefore scores clear.
# Legitimate segments are nowhere near: their 99th percentile turn is 163.
# Swept end to end, every value from 240 down to 160 removes the last of the
# circles without changing a single scenario verdict or losing one reported-ok
# plan, so this sits in the middle of that plateau rather than at either edge.
LOOP_TURN_DEG = 200.0

# How many progressively tighter passes a pillar's goal is retried at when the
# one it wanted turns out to be unreachable from where the robot is. They run
# from the offset asked for down to the tightest that still clears the block at
# all - never past it and never across it, so a relaxed pass is always still on
# the side the colour requires. Giving up some of the dodge is bad; driving a
# circle in front of the pillar is worse, and driving into it is worse still.
RELAXATION_STEPS = 4

# How far a pass goal's heading may be turned off the track heading, in
# degrees, when arriving square to the track cannot be reached from where the
# robot is.
#
# A goal beside a pillar says two things: BE HERE, and be FACING THIS WAY.
# The first is what clears the pillar; the second is only a preference, and
# insisting on it is what made pass goals unreachable near a corner - where
# the track heading is swinging, the robot is close, and there is no
# curvature-bounded path that arrives both beside the pillar and square to a
# line that is itself turning. The planner used to give up on those and drop
# the goal, which left only the exit goal past the pillar, which let the path
# bend smoothly around to it THROUGH the pillar. Being 25 degrees off square
# beside a pillar is not a problem; not being beside it is.
#
# Tried in this order, so square is still preferred wherever it fits. Both
# signs, because which way helps depends on the corner and the side.
PASS_HEADINGS_DEG = (0.0, 12.0, -12.0, 25.0, -25.0, 40.0, -40.0)

# How far BACK along the lap a pass goal may be brought when the pose beside
# the pillar cannot be reached without sweeping the body through something.
#
# This is the axis that actually rescues a corner pass, and it was not obvious.
# Measured over 72 placements around the first bend where the planned body
# overlapped the pillar:
#
#     heading alone, the +/-40 set above      0 of 72
#     heading alone, widened to +/-60         0 of 72
#     lateral offset alone, down to the face  0 of 72
#     moving the goal back along the lap     49 of 72
#
# Because what runs out on a bend is not which way the robot points, it is the
# room beside the pillar AT THAT PROGRESS - the corridor and the bend's own
# inward limit are both functions of progress, so the way to find room is to
# look somewhere else along the lap for it.
#
# BACKWARD ONLY, and that is also measured: allowing forward shifts as well
# rescued FEWER passes (46 of 72) and cost twice the search. A goal moved
# later is one the robot arrives at while it is still swinging out, and it can
# overtake the exit goal that is supposed to follow it.
PASS_SHIFTS_MM = (0.0, -100.0, -200.0, -300.0, -400.0)

# How many candidates are drawn AND SWEPT for one pass goal before the search
# settles for the best it has found. Only the expensive half is bounded: the
# screen in front of it is analytic and costs nothing to run over all of them.
# Measured, a pass that can be met at all is met in a median of 7 sweeps, so
# this cap is reached only where nothing fits - which is exactly the case that
# ends in Plan.compromised anyway, and which must not be allowed to cost the
# control loop its tick on the way there.
MAX_SWEPT_CANDIDATES = 16

# And how many are put through the ANALYTIC screen. Bounded separately and
# more loosely, because dubins_cost neither draws nor sweeps - but bounded all
# the same: it solves all six Dubins words per call and profiling put it at
# 68% of plan(), so an unbounded search over every offset, heading and shift
# is what costs the control loop its tick, not the sweeping that follows it.
MAX_SCREENED_CANDIDATES = 48

# How much coarser the sweep is while SEARCHING than the path finally drawn.
# The winner is redrawn at full resolution before it is returned, so this only
# decides how finely a candidate is inspected before being preferred to
# another - and at 3x it is still one sample per 75mm against a body 140mm
# wide. A collision missed between two coarse samples is not missed twice:
# check() sweeps the finished plan at full resolution and reports it, which is
# the behaviour this whole search is trying to improve on rather than replace.
SEARCH_STEP_FACTOR = 3.0

# How much lap has to be left between the pose a segment starts from and the
# goal it is aimed at. A pass goal brought BACK along the lap must not be
# brought back past the cursor: a goal behind you is one Dubins can only reach
# by turning a full circle, which is the exact failure LOOP_TURN_DEG exists to
# catch, and allowing it turned 4 looping plans in 3000 into 86.
MIN_SEGMENT_MM = 150.0

# ============================================================================
# Geometry
# ============================================================================
# The pillars are 50mm square (block_map.BLOCK_SIZE_MM), taken as a disc of
# this radius for collision purposes. The circumscribed radius rather than the
# inscribed one, because the block's yaw is not tracked and cannot be - a
# square looks the same from every side - so the only honest bound is the one
# that holds at every orientation.
BLOCK_RADIUS_MM = 50.0 * math.sqrt(2.0) / 2.0

# How finely a candidate path is swept for collisions. Half the robot's own
# width would be the loose bound; this is well inside it, and the sweep is one
# vectorised numpy expression whatever the count.
SWEEP_STEP_MM = 25.0

# The robot is checked as three discs down its centerline - rear axle, middle,
# nose - rather than one. A single disc at the centre is optimistic by the
# whole overhang, which is exactly the part that swings out in a corner and
# exactly the part that clips a pillar on the way past.
FOOTPRINT_STATIONS = (-1.0, 0.0, 1.0)


def _where(obstacle):
    """
    Where the plan believes a pillar is and which side it passes it, for the
    reason strings - "pillar +619mm ahead" alone cannot be checked against
    the mat, and a wrong belief about a pillar's position is the first thing
    to rule out when a pass goes wrong.
    """
    if obstacle is None:
        return ""
    return (f"at ({obstacle.x / 10.0:+.0f},{obstacle.y / 10.0:+.0f})cm "
            f"{'R' if obstacle.side > 0 else 'L'}-side ")


def _turn_total_deg(headings):
    """
    Total heading swept along a SAMPLED path, unwrapped, in degrees.

    The planner itself does not use this - it screens candidates with
    dubins_cost, which gets the same number analytically and without drawing
    the path. This is the independent version, measured off the finished
    geometry, and it exists for test_goal_planner.py: a loop check that shares
    its arithmetic with the thing it is checking is not a check.

    Unwrapped because the raw headings wrap at 360 and a naive difference
    would read a loop as a series of small steps with one enormous one in it.
    """
    if len(headings) < 2:
        return 0.0
    return float(np.sum(np.abs(np.diff(np.unwrap(headings, period=360.0)))))


class Plan:
    """
    A planned path plus the reasoning behind it.

    `points` is Nx2 in field mm and `headings` is N in degrees; together they
    are what pure pursuit follows. The rest is for the status line and the
    debug overlay, and for answering "why did it do that" after a run.
    """

    def __init__(self, points, headings, goals, compromised=False, reason="",
                 planned_at=None):
        self.points = points
        self.headings = headings
        self.goals = goals
        self.compromised = bool(compromised)
        self.reason = reason
        # The measured worst gaps along the whole plan, filled in by
        # GoalPlanner.check(). Declared here rather than only there so that a
        # Plan is never half-built: everything that reads them - the status
        # line, the debug overlay, the tests - can read them off any Plan.
        # inf means "nothing of that kind was in range", not "not measured".
        self.pillar_gap_mm = float("inf")
        self.wall_gap_mm = float("inf")
        self.planned_at = time.monotonic() if planned_at is None else planned_at
        # Cumulative arc length, so target_point can step a lookahead along
        # the path without re-measuring it every tick.
        if len(points) > 1:
            steps = np.hypot(*np.diff(points, axis=0).T)
            self.arc = np.concatenate(([0.0], np.cumsum(steps)))
        else:
            self.arc = np.zeros(len(points))

    def __len__(self):
        return len(self.points)

    @property
    def length_mm(self):
        return float(self.arc[-1]) if len(self.arc) else 0.0

    # ========================================================================
    # FOLLOWING
    # ========================================================================

    def nearest_index(self, x, y):
        """Index of the closest sampled point to a field position."""
        offsets = self.points - np.array([x, y])
        return int(np.argmin(np.einsum("ij,ij->i", offsets, offsets)))

    def cross_track_mm(self, x, y):
        """How far the robot is off the plan, unsigned."""
        index = self.nearest_index(x, y)
        return float(np.hypot(*(self.points[index] - np.array([x, y]))))

    def target_point(self, pose, lookahead_mm):
        """
        The point one lookahead along the plan from the robot's closest point
        on it - what pure pursuit steers at.

        Clamped to the last point rather than wrapping: the plan is a finite
        stretch ahead, not a loop, and running off the end of it is the
        planner's cue to make a new one, not something to paper over by
        aiming back at the start.
        """
        if len(self.points) == 0:
            return None
        index = self.nearest_index(pose.x, pose.y)
        wanted = self.arc[index] + float(lookahead_mm)
        ahead = int(np.searchsorted(self.arc, wanted))
        if ahead >= len(self.points):
            return tuple(self.points[-1])
        return tuple(self.points[ahead])

    def remaining_mm(self, x, y):
        """Path left in front of the robot - the trigger to replan."""
        return self.length_mm - float(self.arc[self.nearest_index(x, y)])

    # ========================================================================
    # DRAWING
    # ========================================================================

    def draw(self, canvas, to_px, color=(90, 200, 220), thickness=2):
        """Draws the plan and its goals onto a top-down canvas."""
        import cv2

        if len(self.points) > 1:
            pixels = np.array([to_px(x, y) for x, y in self.points], dtype=np.int32)
            cv2.polylines(canvas, [pixels], isClosed=False, color=color,
                          thickness=thickness)
        for goal in self.goals:
            spot = to_px(goal.x, goal.y)
            # A goal beside a pillar is the one worth seeing; the route goals
            # that carry the plan round the lap are drawn smaller.
            if goal.obstacle is None:
                cv2.circle(canvas, spot, 3, (120, 120, 120), 1)
                continue
            cv2.circle(canvas, spot, 6, (60, 220, 240), 2)
            radians = math.radians(goal.heading)
            nose = to_px(goal.x + 90.0 * math.sin(radians),
                         goal.y + 90.0 * math.cos(radians))
            cv2.line(canvas, spot, nose, (60, 220, 240), 2)
        return canvas


class GoalPlanner:
    """
    Turns "where are the pillars" into "here is a path I have checked".

    Stateless per call: plan() takes the pose and the pillars and returns a
    Plan. What to do when there is no acceptable plan, and how often to ask
    for a new one, are the caller's decisions - see FinalTask.
    """

    def __init__(self, field_map, racing_line, min_radius_mm,
                 robot_half_width_mm=70.0, robot_front_mm=120.0,
                 robot_rear_mm=90.0, clearance_mm=150.0,
                 min_clearance_mm=45.0, wall_clearance_mm=40.0,
                 horizon_mm=2200.0, route_spacing_mm=550.0, max_gates=3,
                 approach_mm=450.0, exit_mm=350.0, align_mm=0.0,
                 step_mm=SWEEP_STEP_MM):
        """
        I/O:
            min_radius_mm: tightest arc a plan may contain. Pass the robot's
                           turning circle with a margin - a path at exactly
                           full lock leaves nothing to correct with.
            clearance_mm: the gap the planner ASKS for between the robot's
                          body and a pillar. Unlike the old clearance_mm this
                          is a preference, not a promise: where the corridor
                          cannot give it, the plan takes less and says so.
            min_clearance_mm: the gap below which a pass is not worth calling
                              a pass. A plan that cannot beat this is
                              compromised and the caller should slow down.
            horizon_mm: how much lap the plan covers. Must comfortably exceed
                        the pursuit lookahead or the robot drives off the end
                        of its own plan between replans.
            max_gates: how many pillars one plan reaches through. Beyond two
                       or three the far ones are re-planned before they are
                       reached anyway, and each costs a pair of goals.
            approach_mm: how far short of a pillar the route goals stop, so
                         nothing pulls the robot back onto the centerline on
                         the run-in to a pass.
            exit_mm: how far past a pillar the plan holds its offset, so the
                     tail is clear before the line folds back.
            align_mm: how far BEFORE the pass pose to put an ALIGN pose,
                     carrying the PASS's heading rather than the track's, so
                     the run-in is straight and the robot is already pointing
                     the right way when it arrives. 0 leaves it out. Past
                     about 250 it starts costing more in wall clearance than
                     it buys beside the pillar - see ALIGN_MM notes in
                     tasks/final/config.toml.
        """
        self.map = field_map
        self.path = racing_line
        self.min_radius_mm = float(min_radius_mm)
        self.half_width_mm = float(robot_half_width_mm)
        self.front_mm = float(robot_front_mm)
        self.rear_mm = float(robot_rear_mm)
        self.clearance_mm = float(clearance_mm)
        self.min_clearance_mm = float(min_clearance_mm)
        self.wall_clearance_mm = float(wall_clearance_mm)
        self.horizon_mm = float(horizon_mm)
        self.route_spacing_mm = float(route_spacing_mm)
        self.max_gates = int(max_gates)
        self.approach_mm = float(approach_mm)
        self.exit_mm = float(exit_mm)
        self.align_mm = float(align_mm)
        self.step_mm = float(step_mm)
        # Boxes the body must stay out of on top of the walls and the map's
        # own obstacles - in practice the parking bay, already grown by the
        # gap wanted from it. See set_keep_out.
        self.keep_out = []

    def set_keep_out(self, rects):
        """
        Replaces the no-go boxes, a sequence of ((x_min, y_min), (x_max, y_max)).

        Planner-only, unlike FieldMap.add_obstacle: these are not walls the
        lidar should raycast, they are ground the plan must not put the body
        on. A pass goal beside one is held off it in _gate_offset, and every
        candidate segment is swept against it in clearances().
        """
        self.keep_out = [(tuple(float(v) for v in low),
                          tuple(float(v) for v in high)) for low, high in rects]
        return self

    # ========================================================================
    # PLANNING
    # ========================================================================

    def plan(self, pose, direction, obstacles=()):
        """
        A checked path from the robot's pose, through the pillars ahead, out
        to the horizon.

        I/O:
            pose: current Pose (x, y, heading)
            direction: +1 or -1, which way round the loop - see RacingLine
            obstacles: iterable of Obstacle, in field mm. Pillars behind the
                       robot are ignored here rather than by the caller, so
                       a pillar just driven past cannot pull the plan back.
            return: Plan. Never None - a plan that could not clear everything
                    is still returned, with `compromised` set and `reason`
                    saying which pillar and by how much, because the robot
                    has to drive something and a bad plan it knows about
                    beats no plan at all.
        """
        progress, lateral = self.path.project(pose.x, pose.y, direction)
        ahead = self._obstacles_ahead(progress, direction, obstacles)
        goals, compromised, reason = self._build_goals(progress, lateral,
                                                       direction, ahead)
        # The pillars go INTO the chaining, not just into the check afterwards:
        # a candidate pass is now accepted for clearing them, not merely for
        # being reachable. See _reach.
        nearby = [item[3] for item in ahead]
        points, headings, driven, skipped = self._chain(pose, goals, direction,
                                                        nearby)
        if skipped:
            compromised = True
            late = "; ".join(f"pillar {self.path.gap(progress, goal.progress):+.0f}mm ahead "
                             f"{_where(goal.obstacle)}unreachable - seen too late"
                             for goal in skipped)
            reason = "; ".join(filter(None, [reason, late]))

        # The pass a goal was RELAXED to is the one that will be driven, so it
        # is the one the plan has to answer for - re-read the shortfalls off
        # the goals that survived rather than off the ones that were asked for.
        for goal in driven:
            if goal.obstacle is not None and goal.clearance_mm < self.min_clearance_mm:
                compromised = True
                shortfall = (f"pillar {self.path.gap(progress, goal.progress):+.0f}mm ahead "
                             f"{_where(goal.obstacle)}gets only {goal.clearance_mm:.0f}mm "
                             f"(asked {self.clearance_mm:.0f})")
                if shortfall not in reason:
                    reason = "; ".join(filter(None, [reason, shortfall]))
        plan = Plan(points, headings, driven, compromised, reason)
        return self.check(plan, nearby)

    def _obstacles_ahead(self, progress, direction, obstacles):
        """
        The pillars in front of the robot, nearest first, with the progress
        each sits at attached.

        "In front" is measured along the lap rather than off the nose, so a
        pillar around the upcoming corner still counts and one just passed
        does not - which is the whole reason the plan is built in the path
        frame instead of the robot's.
        """
        found = []
        for obstacle in obstacles:
            at, lateral = self.path.project(obstacle.x, obstacle.y, direction)
            gap = self.path.gap(progress, at)
            # A small negative gap is a pillar the robot is still alongside;
            # it must keep its goal or the plan snaps straight into it. One
            # robot length back is enough for the tail to have cleared.
            if gap < -(self.rear_mm + BLOCK_RADIUS_MM) or gap > self.horizon_mm:
                continue
            found.append((gap, at, lateral, obstacle))
        found.sort(key=lambda item: item[0])
        return found[:self.max_gates]

    def _build_goals(self, progress, lateral, direction, ahead):
        """
        The goal chain: two beside each pillar, plus route goals filling the
        empty stretches out to the horizon.

        Each pillar gets a PASS goal at its own progress and an EXIT goal one
        exit_mm further on, both at the same offset and both squared up with
        the track - the heading is the racing line's, so the robot arrives
        beside the pillar pointing down the lap rather than across it.

        The exit goal is what keeps the robot out until its tail is clear.
        Without it the plan is free to start folding back toward the line the
        instant the CENTRE of the robot draws level with the pillar, which is
        the moment the rear overhang is still swinging past it. Naming a pose
        the robot must still be in AFTER the pillar costs one goal and removes
        the whole class of clipped-on-the-way-out failures.

        Aiming at a point beside a pillar without also saying which way to be
        facing there is what lets a follower arrive correctly placed and still
        turned into it - which is the argument for goal POSES over goal points,
        and the reason every goal here carries a heading.

        Built as nodes first and turned into poses at the end, because the two
        things that make a chain undrivable - a goal too close to the one
        before it for the offset between them, and an offset that tightens a
        corner past the turning circle - are both properties of NEIGHBOURING
        nodes, and are far easier to enforce on a list of (progress, offset)
        pairs than on finished poses. See _thin.
        """
        nodes = [_Node(progress, lateral, _ROBOT, None, float("inf"), ())]
        horizon = progress + self.horizon_mm
        walked, compromised, reasons = progress, False, []
        # Where the stretch into the next pillar starts from, sideways: the
        # robot itself for the first one, then each pillar's pass offset.
        previous = lateral

        for _, at, pillar_lateral, obstacle in ahead:
            offset, achieved = self._gate_offset(at, pillar_lateral, obstacle,
                                                 direction)
            exit_at = at + self.exit_mm
            # Route nodes bridging the empty stretch since the last pillar, so
            # a long run does not become one enormous Dubins segment that
            # ignores the racing line and cuts the corner off. They stop an
            # approach_mm short of the pillar: a route node sitting on the
            # centerline just before a pass would pull the robot back onto the
            # line at exactly the wrong moment.
            #
            # And they stay OFF the line when both ends of the stretch are on
            # the same side of it. Two pillars wanting the same side used to be
            # bridged on the centreline, so the plan swung back to the middle
            # and out again between them - measured closed loop, from ~240mm
            # out back to 30mm past the line for pillars 1.2-2m apart - a swing
            # toward the other side that nothing on the mat asked for.
            hold = self._held_offset(previous, offset)
            nodes.extend(self._route_nodes(walked, at - self.approach_mm,
                                           hold, direction))
            fallbacks = self._fallback_offsets(offset, pillar_lateral,
                                               obstacle.side)
            nodes.append(_Node(at, offset, _GATE, obstacle, achieved, fallbacks))
            # The exit node carries the SAME offset as the pass, not one
            # re-derived at its own progress. Re-deriving it looks more
            # careful and measures worse: the corridor and corner limits move
            # between the two, so the exit can come out wider than the pass it
            # is supposed to be settling out of, and the plan bulges after the
            # pillar instead of easing back. Measured over 24 runs that turned
            # 0-1 runs with wall contact into 5-8.
            nodes.append(_Node(exit_at, offset, _GATE, obstacle, achieved,
                               fallbacks))
            if achieved < self.min_clearance_mm:
                compromised = True
                reasons.append(f"pillar {self.path.gap(progress, at):+.0f}mm ahead "
                               f"{_where(obstacle)}gets only "
                               f"{achieved:.0f}mm (asked {self.clearance_mm:.0f})")
            walked = exit_at
            previous = offset

        # The tail, out to the horizon - or past it, where a pillar's exit
        # node already ran beyond. Without this floor the chain can END on a
        # pass, which leaves the robot following a plan that stops beside a
        # pillar: the follower clamps to the last point, stops steering, and
        # the round quietly falls apart a metre later. A plan must always
        # reach further ahead than the lookahead can look.
        nodes.extend(self._route_nodes(
            walked, max(horizon, walked + self.route_spacing_mm)))

        goals, seen = [], set()
        for node in self._thin(nodes)[1:]:      # [0] is the robot itself
            goal = self._goal_at(node.progress, node.offset, direction,
                                 node.obstacle, node.clearance, node.fallbacks,
                                 kind="pass" if node.obstacle is not None else "route")
            if node.obstacle is None:
                goals.append(goal)
                continue
            key = (node.obstacle.x, node.obstacle.y)
            if key in seen:
                goals.append(goal._replace(kind="exit"))
                continue
            seen.add(key)
            # An ALIGN pose in front of the pass, carrying the PASS's heading.
            #
            # Mid-corner the pass and the exit take the track tangent at their
            # own progress, and those differ - measured, by 32 degrees - so the
            # plan is still turning as it goes by the pillar and the body leans
            # into it. A pose that shares the pass's heading makes the run-in
            # straight, so the robot arrives already pointing the way it will
            # leave.
            #
            # Translated back along that heading rather than placed at an
            # earlier progress on the line: a pose on the line carrying a
            # heading 30 degrees off it points ACROSS the corridor, and
            # measured that was worse than doing nothing (wall overlaps 32 ->
            # 77). Clamped back into the corridor afterwards because the
            # tangent to an arc leaves the arc, and on a bend an unclamped
            # translation drifts toward the outer wall.
            if self.align_mm > 0.0:
                align = self._translate(goal, -self.align_mm,
                                        direction)._replace(kind="align")
                low_b, high_b = self._lateral_bounds(direction)
                if not low_b <= align.offset <= high_b:
                    held = min(max(align.offset, low_b), high_b)
                    x, y = self.path.point_at(align.progress, direction, held)
                    align = align._replace(x=x, y=y, offset=held)
                # And the same spacing rule _thin applies to everything else.
                # The align pose is inserted AFTER thinning, so nothing else
                # checks there is room for the lateral step into it - and
                # without this there was not: looping plans went from 9 in
                # 3000 to 58, which is Dubins answering "you cannot get there
                # from here" with a circle. A route goal in the way is
                # expendable and gets dropped first, exactly as _thin would;
                # if that is still not enough, the align pose is what goes.
                while goals:
                    previous = goals[-1]
                    span = self.path.gap(previous.progress, align.progress)
                    needed = (self._reachable_span_mm(
                        align.offset - previous.offset) * SPAN_MARGIN)
                    if span >= needed:
                        break
                    if previous.obstacle is None:
                        goals.pop()         # an expendable route goal
                        continue
                    align = None
                    break
                if align is not None:
                    goals.append(align)
            goals.append(goal)
        return goals, compromised, "; ".join(reasons)

    def _goal_at(self, progress, offset, direction, obstacle=None,
                 clearance=float("inf"), fallbacks=(), heading_deg=0.0,
                 kind="route"):
        """
        A goal pose on the racing line at `progress`, held `offset` to the
        right of it and squared up with the track - or turned `heading_deg`
        off square, where square cannot be reached (see PASS_HEADINGS_DEG).
        """
        x, y = self.path.point_at(progress, direction, offset)
        _, _, heading = self.path.pose_at(progress, direction)
        return Goal(x, y, (heading + heading_deg) % 360.0, obstacle, clearance,
                    progress, offset, tuple(fallbacks), kind)

    def _translate(self, goal, distance_mm, direction):
        """
        The same pose, moved along its OWN heading rather than along the track.

        This is what makes a band straight. A pose placed at another progress
        on the racing line carries that progress's heading, and on a bend that
        is a different heading - so two such poses are joined by a curve, and
        the robot is still turning as it goes past the pillar. Two poses that
        share a heading and differ only by a translation along it are joined
        by a straight line, which is the whole point: the body sweeps a
        rectangle beside the pillar instead of an arc that leans into it.

        The progress and offset are re-derived by projection because _reach
        and the reason strings both want to know where along the lap this
        ended up, and after a translation off the line that is no longer the
        progress it was built from.
        """
        radians = math.radians(goal.heading)
        x = goal.x + math.sin(radians) * distance_mm
        y = goal.y + math.cos(radians) * distance_mm
        at, offset = self.path.project(x, y, direction)
        return Goal(x, y, goal.heading, goal.obstacle, goal.clearance_mm,
                    at, offset, goal.fallbacks, goal.kind)

    def _fallback_offsets(self, offset, pillar_lateral, side):
        """
        Tighter passes to fall back on, from the one asked for down to the
        tightest that still clears the block at all.

        Interpolated between two offsets that are BOTH on the required side of
        the pillar, rather than scaled toward zero. Scaling toward zero looks
        equivalent and is not: for a pillar already sitting off the racing
        line, a scaled-down offset crosses the pillar and ends up passing it on
        the side the rules forbid - trading a tight legal pass for a roomy
        illegal one, which scores worse than the collision it was avoiding.

        I/O:
            return: tuple of (offset_mm, clearance_mm), widest first, not
                    including the offset already asked for
        """
        floor = pillar_lateral + side * (BLOCK_RADIUS_MM + self.half_width_mm)
        # Already at or inside the floor: the corridor or the corner has
        # clamped this pass tighter than a fallback would, so there is nothing
        # to give up. Returning steps here would offer offsets WIDER than the
        # one being tried, which reads as a relaxation and is the opposite.
        if abs(offset - pillar_lateral) <= abs(floor - pillar_lateral):
            return ()
        steps = []
        for index in range(1, RELAXATION_STEPS):
            fraction = index / float(RELAXATION_STEPS)
            tighter = offset + (floor - offset) * fraction
            steps.append((tighter, abs(tighter - pillar_lateral)
                          - BLOCK_RADIUS_MM - self.half_width_mm))
        return tuple(steps)

    def _route_nodes(self, from_progress, to_progress, hold=0.0, direction=1):
        """
        Plain nodes on the racing line, spaced along an empty stretch.

        Without these a Dubins segment spanning a whole side of the field is
        free to bow out to the wall on its way - it is the shortest path
        between two poses, and nothing in it prefers the racing line. Pinning
        it every route_spacing_mm keeps the plan on the line wherever there is
        no reason to leave it, which is most of the lap.

        `hold` puts them that far off the line instead (see _held_offset),
        kept inside the corridor and the bend at each node's own progress.
        """
        span = self.path.gap(from_progress, to_progress)
        if span <= 0.0:
            return []
        count = max(1, int(round(span / self.route_spacing_mm)))
        nodes = []
        for step in range(1, count + 1):
            at = from_progress + span * step / count
            offset = self._within_limits(at, hold, direction) if hold else 0.0
            nodes.append(_Node(at, offset, _ROUTE, None, float("inf"), ()))
        return nodes

    @staticmethod
    def _held_offset(previous, offset):
        """
        How far off the line to keep a stretch that starts at `previous` and
        ends at a pass at `offset`: the nearer of the two to the line when
        both are on the same side of it, and the line itself otherwise - a
        stretch between opposite sides still crosses through the middle.
        """
        if previous * offset <= 0.0:
            return 0.0
        return math.copysign(min(abs(previous), abs(offset)), offset)

    def _within_limits(self, at, offset, direction):
        """
        `offset` clamped to what the plan may hold at progress `at`: the
        corridor, the bend's inward limit and the parking bay - the same three
        limits _gate_offset puts on a pass.
        """
        low, high = self._lateral_bounds(direction)
        inward = self.path.inward_limit_mm(at, direction, self.min_radius_mm)
        if math.isfinite(inward):
            if self.path.inward_sign(direction) < 0.0:
                low = max(low, -inward)
            else:
                high = min(high, inward)
        outward = self._keep_out_limit_mm(at, direction)
        if math.isfinite(outward):
            if direction > 0:
                high = min(high, outward)
            else:
                low = max(low, -outward)
        return float(np.clip(offset, low, high))

    def _reachable_span_mm(self, offset_change):
        """
        The least along-track distance in which the plan can move sideways by
        `offset_change` and still be drivable.

        Two goals with the same heading and a lateral step between them are
        joined by an S of two arcs at the turning circle. That S needs room:
        for a step d between poses at radius R the arcs turn through
        acos(1 - d/2R) each, and the pair spans 2R sin of that. Ask for the
        step in less distance than that and there IS no curvature-bounded path
        with those end headings - Dubins will answer with a loop, because a
        loop is the shortest thing that exists, and the robot will drive a
        circle in the middle of the track.

        That loop is not hypothetical: it is what the first version of this
        planner did, and it is why the spacing is enforced here rather than
        left to the solver to complain about. Dubins never complains.

        I/O:
            return: mm, or inf if the step is more than the geometry can do
                    at any distance (a step wider than two turning circles)
        """
        step = abs(offset_change)
        if step < 1e-6:
            return 0.0
        radius = self.min_radius_mm
        if step >= 2.0 * radius:
            return float("inf")
        return 2.0 * radius * math.sin(math.acos(1.0 - step / (2.0 * radius)))

    def _thin(self, nodes):
        """
        Drops nodes the chain cannot reach in the room available.

        Walks the list keeping a running "last node that survived", and where
        the next one is closer than _reachable_span_mm allows, removes the
        LESS important of the two: a route node exists only to keep the plan
        near the racing line and is always worth losing, while a pillar's pass
        and exit nodes are the reason the plan exists and are never dropped.
        The robot's own node heads the list and outranks everything, since the
        chain has to start where the robot actually is.

        The usual outcome on the approach to a pillar is that the last route
        node before it disappears, and the plan runs from wherever the robot
        is straight into the pass - which is the correct answer, and the one
        the old profile could not express because it had to be continuous
        everywhere.
        """
        kept = [nodes[0]]
        for node in nodes[1:]:
            while True:
                previous = kept[-1]
                span = self.path.gap(previous.progress, node.progress)
                needed = (self._reachable_span_mm(node.offset - previous.offset)
                          * SPAN_MARGIN)
                if span >= needed:
                    kept.append(node)
                    break
                if previous.rank == _ROUTE:
                    kept.pop()          # the earlier node was the expendable one
                    continue
                if node.rank == _ROUTE:
                    break               # keep what we have, drop this node
                # Two nodes that both have to exist, too close together for the
                # step between them - a pillar the corridor wants passed on one
                # side hard on the heels of one that wanted the other. Both are
                # kept and _chain relaxes the offsets until something is
                # drivable, because the alternative is dropping a pillar's goal
                # and driving at it as though it were not there.
                kept.append(node)
                break
        return kept

    def _lateral_bounds(self, direction):
        """
        How far the plan may sit either side of the racing line, as
        (low, high) in the travel frame where + is to the right of travel.

        Which SIGN points at the outer wall depends on which way round the
        loop is being driven - the wall is on the right going the +1 way and
        on the left going the other - so a symmetric clamp would restrict the
        centre-block side by mistake half the time.
        """
        toward_wall, toward_block = self.path.lateral_room_mm(
            self.wall_clearance_mm + self.half_width_mm)
        if direction > 0:
            return -toward_block, toward_wall
        return -toward_wall, toward_block

    def _gate_offset(self, at, lateral, obstacle, direction):
        """
        Where beside a pillar the robot's centerline should pass, and the body
        clearance that actually buys.

        The wanted offset is the pillar's own lateral position plus, on the
        side its colour dictates, enough room for the block's half-diagonal,
        the robot's half width and the clearance asked for. Where the corridor
        will not take that, the offset is pulled back to the wall limit and
        THE CLEARANCE THAT SURVIVES IS RETURNED rather than assumed.

        That return value is the whole point of the rewrite. The old code did
        the same clamp and then carried on as though the clearance were
        intact, so a pillar the corridor could not accommodate produced a
        confident plan and a collision. Here the shortfall comes back with the
        offset, reaches Plan.reason, and reaches the status line.

        I/O:
            return: (offset_mm in the travel frame, achieved body clearance)
        """
        needed = BLOCK_RADIUS_MM + self.half_width_mm + self.clearance_mm
        wanted = lateral + obstacle.side * needed
        low, high = self._lateral_bounds(direction)

        # Inside a bend the corridor is not the only limit. A plan held `d` mm
        # inside an arc of radius R is itself an arc of radius R - d, so an
        # inward pass spends the corner's radius one for one, and at
        # R - d below the turning circle there is no path that follows it.
        # Dubins answers that with a loop rather than an error (see
        # _reachable_span_mm), so it has to be caught rather than discovered.
        #
        # This limit was tried as a property of the EXIT goal alone, on the
        # reasoning that a pass goal is only gone THROUGH and a path may touch
        # a curvature it could not sustain. It is true, and it does not help:
        # letting the pass reach further inside a bend bought nothing on
        # pillar clearance (97%/87% either way, measured over 24 runs) and
        # cost a great deal on the walls, because the path that cuts in at an
        # angle also bows inside the goal it is cutting to, and inside a bend
        # what it bows into is the centre block. Wall contact went from 0-1
        # runs in 12 to 5-8. The cap does two jobs and only one of them is
        # about curvature.
        #
        # Measured against the BARE turning circle: min_radius_mm already
        # carries the caller's margin (see FinalTask._steerable_radius_mm),
        # and padding it twice cost a corner pass most of its clearance.
        inward = self.path.inward_limit_mm(at, direction, self.min_radius_mm)
        if math.isfinite(inward):
            if self.path.inward_sign(direction) < 0.0:
                low = max(low, -inward)
            else:
                high = min(high, inward)

        # And beside the parking bay the wall side ends at the bay's tips,
        # not at the wall. Without this the pass is placed as though the
        # wall were flat, the sweep rejects it, and the search runs out of
        # candidates before it relaxes far enough to find the gap between
        # the pillar and the bay - so the least-bad pass, into the bay, won.
        outward = self._keep_out_limit_mm(at, direction)
        if math.isfinite(outward):
            if direction > 0:
                high = min(high, outward)
            else:
                low = max(low, -outward)

        offset = float(np.clip(wanted, low, high))

        # The clamp can land the centerline on the WRONG SIDE of the pillar,
        # which is not a tight pass but a pass on the side the rules forbid.
        # Where that happens the offset is pushed to the far edge of the
        # corridor on the required side instead - a pass that is legal and
        # tight beats one that is roomy and scored as a fault.
        if (offset - lateral) * obstacle.side <= 0.0:
            offset = high if obstacle.side > 0 else low
        return offset, abs(offset - lateral) - BLOCK_RADIUS_MM - self.half_width_mm

    def _keep_out_limit_mm(self, at, direction):
        """
        How far toward the outer wall the centerline may go for a pass at
        `at`, given the keep-out boxes, or inf where none is in reach.

        A box counts when the body could be beside it while holding the pass:
        from the align pose and the run-in before it, back by the rear
        overhang, out to the exit and the nose past that.

        I/O:
            return: a distance in mm from the racing line, toward the wall
        """
        wall_sign = 1.0 if direction > 0 else -1.0
        before = self.align_mm + self.approach_mm + self.rear_mm
        after = self.exit_mm + self.front_mm
        limit = float("inf")
        for (x0, y0), (x1, y1) in self.keep_out:
            gaps, near = [], float("inf")
            for x, y in ((x0, y0), (x0, y1), (x1, y0), (x1, y1)):
                progress, lateral = self.path.project(x, y, direction)
                gaps.append(self.path.gap(at, progress))
                near = min(near, lateral * wall_sign)
            if min(gaps) > after or max(gaps) < -before:
                continue
            limit = min(limit, near - self.half_width_mm)
        return limit

    # ========================================================================
    # CHAINING
    # ========================================================================

    def _chain(self, pose, goals, direction, obstacles=()):
        """
        Dubins from the pose through every goal in order, concatenated.

        Each segment starts where the last one ended - at the goal pose, not
        at wherever the last sample happened to fall - so the joins are exact
        and the whole chain stays inside the curvature bound.

        Two things can go wrong with a segment, and they want opposite
        treatment:

          * it will not solve at all, which for Dubins means the two poses sat
            on top of each other. Skipped; the next goal picks the chain up.

          * it solves into a LOOP. Dubins returns the shortest path that
            exists, and when a goal is too close, or too far off to the side
            to reach in the room left, the shortest path that exists is a
            circle - so the failure arrives disguised as a valid answer.
            _thin removes most of these by construction, but it reasons about
            a straight reference and the real track bends, so the ones a
            corner creates survive it. They are caught here instead, on the
            finished geometry, where there is nothing left to be wrong about.

        A looping ROUTE goal is dropped - it only existed to keep the plan
        near the racing line. A looping PILLAR goal is retried at progressively
        smaller offsets (RELAXATIONS) until one is reachable, and the clearance
        that survives is written back into the goal, so a pass the robot had to
        give ground on still reports what it actually got.

        Which candidate a goal settles on is _reach's business, and it is not
        only about whether the steering can hold it: the segment is SWEPT
        before it is accepted, so a pass that would put the body through the
        pillar it is dodging is rejected here rather than merely reported by
        check() afterwards. That is why the pillars are passed in.

        I/O:
            obstacles: the pillars the segments are swept against - see
                       _reach. Without them a pass goal is only checked for
                       being REACHABLE, which is not the same question.
            return: (points Nx2, headings N, goals actually used, skipped)
        """
        points = [np.array([[pose.x, pose.y]])]
        headings = [np.array([pose.heading])]
        cursor = (pose.x, pose.y, pose.heading)
        driven, skipped = [], []

        for goal in goals:
            attempt, segment = self._reach(cursor, goal, direction, obstacles)
            if segment is None:
                # Nothing from the full offset down to the tightest fallback
                # was reachable from here. A route goal is no loss. A PILLAR
                # goal is: skipping it drives the racing line straight through
                # the pass, which is the one outcome this planner exists to
                # prevent, so it is recorded and surfaced rather than dropped
                # quietly. It happens when a pillar is confirmed so late that
                # there is no longer room to get beside it - the exit goal
                # that follows is further away and usually still reachable, so
                # the pass often still happens, just late and tight.
                # An ALIGN goal is a convenience and is allowed to be lost:
                # without it the plan runs straight into the pass, which is
                # what it did before align_mm existed. Reporting the round
                # COMPROMISED over one would be crying wolf, and a status line
                # that cries wolf is one nobody reads on the mat.
                if goal.obstacle is not None and goal.kind != "align":
                    skipped.append(goal)
                continue
            # Drop the first sample: it is the previous segment's last point.
            points.append(segment.points[1:])
            headings.append(segment.headings[1:])
            cursor = (attempt.x, attempt.y, attempt.heading)
            driven.append(attempt)

        return np.vstack(points), np.concatenate(headings), driven, skipped

    def _reach(self, cursor, goal, direction, obstacles):
        """
        The pose to actually drive at for one goal, and the path to it.

        THE DIFFERENCE THIS MAKES, and the reason it exists: a candidate used
        to be accepted for being REACHABLE - dubins_cost said the steering
        could hold it and no more was asked. Whether the robot's body cleared
        the pillar on the way was a different question, and it was not asked
        until check(), by which time the plan was built and the answer could
        only be reported. So a pass on a bend could be planned straight
        through the pillar it was dodging, confidently, and the round would
        drive it slowly rather than drive a clear one.

        Reachability and clearance are now the same test. Candidates are tried
        in preference order and the first one whose SWEPT BODY is clear wins;
        the cheap answer - beside the pillar, square to the track, full offset
        - is still tried first and still wins almost every time, so the common
        case costs one extra sweep and nothing else.

        WHAT GETS SPENT, cheapest first (see _attempts):

            1. WHERE ALONG THE LAP the pass happens. Free: arriving at the
               offset earlier is if anything better, since the robot is
               already settled when it draws level with the pillar.
            2. BEING SQUARE to the track. A preference, not a clearance.
            3. THE CLEARANCE ITSELF, last, because it is the only one of the
               three that is actually keeping the robot off the pillar.

        When nothing is clear the best-scoring candidate is driven anyway and
        check() reports it - that is deliberate and unchanged. Roughly a fifth
        of corner placements have no solution at all: the corridor is full,
        something has to be driven, and a bad plan the round KNOWS about beats
        a confident one it does not.

        I/O:
            cursor: (x, y, heading) the segment starts from
            obstacles: pillars to sweep against; walls, the centre block and
                       the bay come from the map inside clearances()
            return: (goal actually used, sampled segment), or (None, None)
        """
        # How much lap there is between where this segment starts and the goal
        # it aims at. Signed: NEGATIVE means the goal is already behind the
        # pose this segment starts from, which happens without anything being
        # shifted at all - two pillars close together put the second one's
        # pass goal behind the first one's exit pose. See the floor below.
        here, _ = self.path.project(cursor[0], cursor[1], direction)
        lap_room = self.path.gap(here, goal.progress)
        search_step = self.step_mm * SEARCH_STEP_FACTOR

        best = None                     # (score, candidate)
        first = None                    # the cheap answer, kept as a floor
        swept = screened = 0

        # The goal exactly as _build_goals made it, first. For an ordinary
        # goal this is what _attempts would have produced anyway; for one that
        # was TRANSLATED off the racing line it is the only way to try it at
        # all, since every _attempts candidate is rebuilt from a progress and
        # an offset and would quietly undo the translation.
        # Gated on an align pose being configured at all, so that with
        # align_mm off this is not on the path and the round behaves exactly
        # as it did. The same overlap prune applies as everywhere else: a pose
        # already inside the pillar is not a candidate however it was built.
        # `lap_room > 0.0` for the same reason the attempts loop below tests
        # it: this branch bypasses _attempts entirely, so without it a goal
        # behind the cursor is drawn HERE instead and the guard below never
        # gets to see it.
        translated = self.align_mm > 0.0
        if (translated and lap_room > 0.0 and goal.obstacle is not None
                and math.hypot(goal.x - goal.obstacle.x,
                               goal.y - goal.obstacle.y)
                > BLOCK_RADIUS_MM + self.half_width_mm):
            _, turned = dubins_cost(cursor, (goal.x, goal.y, goal.heading),
                                    self.min_radius_mm)
            if turned <= LOOP_TURN_DEG:
                segment = plan_dubins(cursor, (goal.x, goal.y, goal.heading),
                                      self.min_radius_mm, step_mm=search_step)
                if segment is not None and len(segment.points) >= 2:
                    first = goal
                    score = min(self.clearances(segment.points,
                                                segment.headings, obstacles))
                    if score > 0.0:
                        return self._draw(cursor, goal)
                    best = (score, goal)
                    swept += 1

        for offset, clearance, turn, shift in self._attempts(goal):
            # Every candidate has to lie AHEAD of the pose its segment starts
            # from, whether or not anything was shifted. A goal behind you is
            # one Dubins reaches by going all the way round, because a circle
            # is the shortest thing that gets there - and it arrives disguised
            # as a valid answer. Testing only the SHIFT missed the case where
            # the goal was already behind at shift 0, which measured over 3000
            # random layouts was 13 of the 15 plans that drove a circle.
            #
            # The floor is MIN_SEGMENT_MM only for a goal being pulled BACK,
            # because that constant is about not SPENDING lap room the segment
            # does not have. A goal at its built progress is required to be
            # ahead and nothing more: align_mm routinely leaves an align pose
            # within 150mm of the pass it feeds - 139mm on the plain
            # one-pillar case - so demanding the full margin there drops
            # ordinary passes. Near-zero room with a big turn is real, and it
            # is LOOP_TURN_DEG below that catches it, not this.
            if lap_room + shift <= (MIN_SEGMENT_MM if shift < 0.0 else 0.0):
                continue
            candidate = self._goal_at(goal.progress + shift, offset, direction,
                                      goal.obstacle, clearance,
                                      goal.fallbacks, heading_deg=turn,
                                      kind=goal.kind)

            # Two coordinates decide whether the body AT the goal is already
            # inside the pillar, and a candidate that fails that can never
            # produce a clear segment. Tested BEFORE dubins_cost, not after:
            # the analytic screen is the most expensive thing in this loop by
            # a wide margin - measured, 68% of plan() - because it solves all
            # six Dubins words to answer one question. Never pay it for a
            # candidate two subtractions can reject.
            if goal.obstacle is not None and math.hypot(
                    candidate.x - goal.obstacle.x,
                    candidate.y - goal.obstacle.y) <= (
                    BLOCK_RADIUS_MM + self.half_width_mm):
                continue

            screened += 1
            if screened > MAX_SCREENED_CANDIDATES:
                break
            _, turned = dubins_cost(
                cursor, (candidate.x, candidate.y, candidate.heading),
                self.min_radius_mm)
            if turned > LOOP_TURN_DEG:
                continue

            # A route goal is one pose on the racing line, take it or leave
            # it. There is nothing for it to be dodging and nothing to search,
            # so it is accepted exactly as it always was.
            if goal.obstacle is None:
                return self._draw(cursor, candidate)

            if first is None:
                first = candidate       # what the planner would have taken

            segment = plan_dubins(cursor,
                                  (candidate.x, candidate.y, candidate.heading),
                                  self.min_radius_mm, step_mm=search_step)
            if segment is None or len(segment.points) < 2:
                continue

            pillar_gap, wall_gap = self.clearances(
                segment.points, segment.headings, obstacles)
            score = min(pillar_gap, wall_gap)
            if score > 0.0:
                return self._draw(cursor, candidate)
            if best is None or score > best[0]:
                best = (score, candidate)

            swept += 1
            if swept >= MAX_SWEPT_CANDIDATES:
                break

        # Nothing was clear. Drive the least-bad thing found, or - where the
        # search never got as far as scoring anything - the candidate the
        # planner would have taken before any of this existed. Falling back to
        # that rather than to nothing is what keeps a pass that cannot be given
        # its clearance a REPORTED tight pass instead of a dropped goal.
        chosen = best[1] if best is not None else first
        if chosen is None:
            return None, None
        return self._draw(cursor, chosen)

    def _draw(self, cursor, candidate):
        """One candidate, sampled at the resolution the plan is followed at."""
        segment = plan_dubins(cursor,
                              (candidate.x, candidate.y, candidate.heading),
                              self.min_radius_mm, step_mm=self.step_mm)
        if segment is None or len(segment.points) < 2:
            return None, None
        return candidate, segment

    def _attempts(self, goal):
        """
        The (offset, clearance, heading turn, progress shift) tuples to try for
        one goal, best first.

        Ordered offset-outermost so that GIVING UP CLEARANCE IS THE LAST
        RESORT: every heading and every shift is tried at the full offset
        before any of them is tried at a reduced one. Clearance is what
        actually stops the robot touching the pillar; being square to the
        track and passing at the pillar's own progress are both preferences,
        so the preferences are what get spent first.

        The shift is innermost, which makes it the FIRST thing spent - it is
        the cheapest of the three and, on a bend, much the most effective.
        See PASS_SHIFTS_MM for the measurements.

        A route goal has none of the three to spend, so it is one attempt.
        """
        if goal.obstacle is None:
            return [(goal.offset, goal.clearance_mm, 0.0, 0.0)]
        attempts = []
        for offset, clearance in [(goal.offset, goal.clearance_mm)] + list(goal.fallbacks):
            # One preference at a time, not the cross product of all of them.
            # Moving the goal back while ALSO turning it off square is both the
            # most expensive part of the search and the least useful: the two
            # are alternative ways of buying the same room, so trying every
            # combination multiplies the cost of the analytic screen - the
            # dominant cost in here - without finding passes that one axis
            # alone would not. 11 candidates an offset rather than 35.
            for shift in PASS_SHIFTS_MM:
                attempts.append((offset, clearance, 0.0, shift))
            for turn in PASS_HEADINGS_DEG[1:]:
                attempts.append((offset, clearance, turn, 0.0))
        return attempts

    # ========================================================================
    # CHECKING
    # ========================================================================

    def footprint(self, points, headings):
        """
        The robot's body swept along a path, as discs.

        Three per sample - rear axle, middle, nose - because a single disc at
        the centre understates the swing of the overhangs through a corner by
        exactly the amount that clips a pillar.

        I/O:
            return: Mx2 array of disc centres, M = 3 x len(points)
        """
        radians = np.radians(headings)
        forward = np.column_stack((np.sin(radians), np.cos(radians)))
        spans = {-1.0: -self.rear_mm, 0.0: 0.0, 1.0: self.front_mm}
        return np.vstack([points + forward * spans[station]
                          for station in FOOTPRINT_STATIONS])

    def clearances(self, points, headings, obstacles):
        """
        The worst gap between the robot's body and each hazard along a path.

        One vectorised pass over every disc against every hazard, which is
        what makes it affordable to check a plan properly rather than trusting
        the geometry that produced it.

        I/O:
            return: (pillar_gap_mm, wall_gap_mm). Either may be negative,
                    which means the body overlaps - a collision, not a
                    tight pass.
        """
        body = self.footprint(points, headings)

        pillar_gap = float("inf")
        for obstacle in obstacles:
            offsets = body - np.array([obstacle.x, obstacle.y])
            distance = np.min(np.hypot(offsets[:, 0], offsets[:, 1]))
            pillar_gap = min(pillar_gap,
                             distance - BLOCK_RADIUS_MM - self.half_width_mm)

        # Outer wall: how far the nearest disc centre stays inside the box,
        # less the body radius. The field is axis aligned, so the gap to the
        # box is the smaller of the two axes' gaps.
        to_outer = np.minimum(self.map.outer - np.abs(body[:, 0]),
                              self.map.outer - np.abs(body[:, 1]))
        # Centre block: OUTSIDE this box, so the gap is how far the nearest
        # disc is from it - positive on the larger of the two axes.
        to_inner = np.maximum(np.abs(body[:, 0]) - self.map.inner,
                              np.abs(body[:, 1]) - self.map.inner)
        wall_gap = float(min(np.min(to_outer), np.min(to_inner))) - self.half_width_mm

        for low, high in list(getattr(self.map, "obstacles", ())) + self.keep_out:
            # A bay wall is a box the body must stay out of: the gap is the
            # distance from each disc centre to the box, zero inside it.
            dx = np.maximum(np.maximum(low[0] - body[:, 0], body[:, 0] - high[0]), 0.0)
            dy = np.maximum(np.maximum(low[1] - body[:, 1], body[:, 1] - high[1]), 0.0)
            wall_gap = min(wall_gap,
                           float(np.min(np.hypot(dx, dy))) - self.half_width_mm)

        return pillar_gap, wall_gap

    def check(self, plan, obstacles):
        """
        Sweeps a finished plan and folds the result back into it.

        Called after planning rather than during: the goals are placed with
        the corridor already in mind, so this is the independent check that
        they were placed correctly, not the mechanism that places them. A plan
        that fails here is a bug in the goal placement or a pillar the
        corridor genuinely cannot accommodate - both worth knowing about.

        I/O:
            return: the same Plan, with `compromised` and `reason` updated
        """
        if len(plan.points) < 2:
            return plan
        pillar_gap, wall_gap = self.clearances(plan.points, plan.headings,
                                               obstacles)
        plan.pillar_gap_mm = pillar_gap
        plan.wall_gap_mm = wall_gap

        faults = []
        if pillar_gap < self.min_clearance_mm:
            faults.append(f"pillar gap {pillar_gap:.0f}mm")
        # Half of what was asked for, not zero. The goals are placed with a
        # full wall_clearance_mm in hand, but the path BETWEEN two goals is
        # free to bow a little further out than either of them, so measuring
        # against zero passes a plan that grazes the wall with nothing left
        # for pose error - and the pose is exactly what is least trustworthy
        # near a wall. Half is the point at which the bow has eaten enough of
        # the margin to be worth saying out loud.
        if wall_gap < self.wall_clearance_mm / 2.0:
            faults.append(f"wall gap {wall_gap:.0f}mm")
        if faults:
            plan.compromised = True
            plan.reason = "; ".join(filter(None, [plan.reason] + faults))
        return plan

    def __str__(self):
        return (f"GoalPlanner min_r={self.min_radius_mm:.0f}mm "
                f"clearance={self.clearance_mm:.0f}mm "
                f"horizon={self.horizon_mm:.0f}mm gates={self.max_gates}")
