chankrrn/WRO-FE-YBR-SUNFLOWER/src/Raspberrypi/classes/task_context.py

import time

from classes.board_manager import BoardManager
from classes.compass_manager import CompassManager
from classes.light_sensor_manager import LightSensorManager
from classes.motor_manager import MotorManager
from classes.navigation_manager import NavigationManager
from classes.navigator import Navigator
from classes.start_button import StartButton
from classes.ultra_servo_manager import UltraServoManager


class TaskContext:
    """
    Everything a task runs on: every piece of hardware, the navigator built on
    top of them, and the startup/shutdown order that ties them together.

    A task never constructs hardware itself - it gets a started TaskContext and
    talks to context.motor, context.compass, context.navigator and so on. That
    keeps "how the robot is wired" in one place and lets the qualification and
    final rounds share it.

    Optional subsystems are opt-in because they cost time and are not needed by
    every round:
        use_lidar   - LidarManager (RPLidar S2L on the Pi's UART)
        use_camera  - CameraManager + ObjectSolver (final round pillars)

    `no_drive` keeps every subsystem exactly as it is but stops the drive
    motor ever turning, so a round can be walked through by hand - see
    MotorManager.drive_enabled.

    context.nav reports the pose of the REAR AXLE. The lidar is on a mast at
    the front of the car, `lidar_ahead_mm` ahead of that, and the localizer
    casts its rays from there - see classes/robot_geometry.py.

    Usage:
        with TaskContext(debug=True) as context:
            context.motor.forward(55)
            print(context.nav.get_pose())
    """

    def __init__(self, debug=False, ascii_debug=False, use_lidar=False, use_camera=False,
                 laps_goal=3, lidar_port=None,
                 start_pose=None, no_drive=False, lidar_ahead_mm=None,
                 record_video=False):
        """
        I/O:
            lidar_ahead_mm: how far the lidar sits ahead of the rear axle,
                            which is the point every pose describes. None
                            takes robot_geometry's measured default; a round
                            passes its robot.lidar_ahead_mm so the config is
                            the one place the number lives.
        """
        self.debug = debug
        self.ascii_debug = ascii_debug
        self.record_video = bool(record_video)
        self.use_lidar = use_lidar
        self.use_camera = use_camera
        self.start_pose = start_pose
        self.no_drive = no_drive

        self.board = BoardManager(debug=debug)
        self.motor = MotorManager(self.board, debug=debug,
                                  drive_enabled=not no_drive)
        self.start_button = StartButton(debug=debug)
        self.compass = CompassManager(debug=debug)
        self.ultra = UltraServoManager(self.board, debug=debug)
        self.lights = LightSensorManager(self.board, debug=debug)
        self.navigator = Navigator(self.compass, self.ultra, laps_goal=laps_goal, debug=debug)

        # Always constructed so context.nav.get_pose() is safe to call from any
        # task, but it only has anything to localize against once the lidar is
        # up - without it every pose comes back with confidence 0.
        nav_options = {}
        if lidar_ahead_mm is not None:
            nav_options["lidar_offset_mm"] = (float(lidar_ahead_mm), 0.0)
        self.nav = NavigationManager(compass=self.compass, debug=debug, **nav_options)

        # Built during startup only when asked for.
        self.lidar = None
        self.camera = None
        self.object_solver = None
        self.vision = None
        self._lidar_port = lidar_port

        self._gpio = None
        self.started = False

    # ========================================================================
    # LIFECYCLE
    # ========================================================================

    def startup(self):
        """
        Brings every subsystem up in dependency order (the expansion board
        first - the steering servo, ultrasonic and light sensors all hang off
        it). Anything that fails here raises, except the compass and the
        optional subsystems, which warn and carry on degraded.
        """
        if self.started:
            return self

        steps = [("GPIO", self._init_gpio),
                 ("Start button", self.start_button.start),
                 ("Expansion board", self.board.start),
                 ("Motor", self.motor.start),
                #  ("Ultrasonic servo", self.ultra.start),
                 ("Compass", self.compass.start)]
        if self.use_lidar:
            steps.append(("Lidar", self._init_lidar))
        if self.use_camera:
            steps.append(("Camera", self._init_camera))
        # Last: it needs the compass anchored and the lidar already spinning.
        steps.append(("Navigation", self._init_nav))
        if self.use_camera:
            # After Navigation, not with Camera: the vision thread reads the
            # filter's pose, so the filter has to be seeded before it runs.
            steps.append(("Vision", self._start_vision))

        print("=" * 70)
        for index, (name, init) in enumerate(steps, start=1):
            print(f"[{index}/{len(steps)}] {name}...")
            init()
            print("  OK")
        print("=" * 70)

        self.started = True
        return self

    def shutdown(self):
        """Safe to call twice, and safe to call after a failed startup."""
        print("\nShutting down...")
        self.motor.stop_and_close()
        # Before the camera: the thread is holding it.
        if self.vision is not None:
            self.vision.stop()
            self.vision = None
        # self.ultra.stop()
        self.nav.stop()
        if self.lidar is not None:
            self.lidar.stop()
            self.lidar = None
        if self.camera is not None:
            try:
                self.camera.release_video()
            except Exception:
                pass
            self.camera = None
        self.compass.stop()
        self.board.stop()
        self.start_button.stop()
        self._cleanup_gpio()
        self.started = False
        print("Done\n")

    def __enter__(self):
        return self.startup()

    def __exit__(self, exc_type, exc, tb):
        self.shutdown()
        return False

    # ========================================================================
    # SUBSYSTEM SETUP
    # ========================================================================

    def _init_gpio(self):
        import RPi.GPIO as GPIO

        # A previous run that died without cleaning up leaves the pins claimed,
        # so clear them before taking them again. Warnings go off first, or a
        # clean boot logs "nothing to clean up" every single run.
        GPIO.setwarnings(False)
        try:
            GPIO.cleanup()
        except Exception:
            pass
        time.sleep(0.2)
        GPIO.setmode(GPIO.BCM)
        self._gpio = GPIO

    def _cleanup_gpio(self):
        if self._gpio is None:
            return
        try:
            self._gpio.cleanup()
        except Exception:
            pass
        self._gpio = None

    def _init_lidar(self):
        from classes.lidar_manager import LidarManager

        self.lidar = LidarManager(port=self._lidar_port, debug=self.debug)
        self.lidar.start()
        if not self.lidar.wait_until_ready(timeout=5.0):
            print("  WARNING: lidar returned little data - is it spinning?")

    def _init_nav(self):
        """
        Points the localizer at whatever hardware actually came up and seeds
        the particle cloud.

        With `start_pose` the filter knows where it is from the first scan.
        Without it, it searches the whole field - which works, but the map is
        90-degree symmetric, so if the compass is also dead it can settle into
        the wrong quadrant. Give it a start pose when you know one.
        """
        self.nav.lidar = self.lidar
        self.nav.compass = self.compass if self.compass.is_available else None
        if self.lidar is None:
            print("  no lidar - poses will report confidence 0")

        self.nav.start(*(self.start_pose or ()))
        pose = self.nav.get_pose()
        print(f"  pose: {pose}")

    def _init_camera(self):
        from camera_manager import CameraManager
        from classes.object_solver import ObjectSolver

        try:
            # The recorder's frame rate is the VISION thread's, not the
            # camera's - that loop is what feeds it - so it comes from the same
            # constant the loop paces itself with.
            from classes.vision_manager import DEFAULT_MIN_PERIOD_S
            self.camera = CameraManager(record_video=self.record_video,
                                        record_fps=1.0 / DEFAULT_MIN_PERIOD_S)
            self.camera.start_camera()
            self.object_solver = ObjectSolver(debug=self.debug)
        except Exception as e:
            self.camera = None
            self.object_solver = None
            print(f"  WARNING: camera unavailable ({e!r}) - continuing without it")

    def _start_vision(self):
        """
        Puts the detection pipeline on its own thread.

        It starts paused - see VisionManager - and the round resumes it once
        the filter has localized, because a detection placed with a pose that
        has not converged is thrown away anyway.
        """
        from classes.vision_manager import VisionManager

        if self.camera is None or self.object_solver is None:
            print("  no camera - pillars will not be mapped")
            return
        try:
            self.vision = VisionManager(self.camera, self.object_solver, self.nav,
                                        debug=self.debug,
                                        record=self.record_video).start()
        except Exception as e:
            self.vision = None
            print(f"  WARNING: vision thread unavailable ({e!r}) - the round will "
                  f"detect inline instead")

    # ========================================================================
    # SHARED HELPERS
    # ========================================================================

    def wait_for_start(self):
        """Blocks on the physical start button."""
        self.start_button.wait()

    def emergency_stop(self):
        try:
            self.motor.stop()
            self.motor.steer_center()
        except Exception:
            pass
