chankrrn/WRO-FE-YBR-SUNFLOWER/src/Raspberrypi/classes/start_button.py

import time

# ============================================================================
# Hardware wiring
# ============================================================================
# BCM pin the start button is on ("digital 16" on the DFR0604), wired between
# the pin and GND - the internal pull-up holds it high until the button is
# pressed. (It used to hang off the Arduino's A0, read the same way: high =
# waiting, low = go.)
START_BUTTON_PIN = 16

# The 40-pin header's GPIO chip. lgpio rather than RPi.GPIO, which cannot
# drive a Pi 5's pins at all ("Cannot determine SOC peripheral base address").
GPIO_CHIP = 0

# What the pin reads while the button is held. 0 for a plain button to GND (the
# pull-up holds it at 1 otherwise); 1 for a Gravity button module, which drives
# the signal HIGH when pressed.
PRESSED_LEVEL = 1

# The press has to read low for this long to count, so a bounce or a glitch on
# the wire cannot start a round.
DEBOUNCE_S = 0.05
POLL_S = 0.01

# Time to take the hand away before the robot moves. Same as the Arduino did.
RELEASE_DELAY_S = 0.8


class StartButton:
    """
    The physical button that starts a round.
    """

    def __init__(self, pin=START_BUTTON_PIN, chip=GPIO_CHIP, debug=False):
        self.pin = pin
        self.chip = chip
        self.debug = debug
        self._handle = None

    def start(self):
        import lgpio

        handle = lgpio.gpiochip_open(self.chip)
        try:
            lgpio.gpio_claim_input(handle, self.pin, lgpio.SET_PULL_UP)
        except Exception:
            lgpio.gpiochip_close(handle)
            raise
        self._lgpio = lgpio
        self._handle = handle
        if self.debug:
            print(f"[start] button on BCM {self.pin}, currently "
                  f"{'pressed' if self.is_pressed() else 'released'}")

    def stop(self):
        if self._handle is None:
            return
        try:
            self._lgpio.gpiochip_close(self._handle)
        except Exception:
            pass
        self._handle = None

    def is_pressed(self):
        if self._handle is None:
            raise RuntimeError("StartButton.start() must be called first")
        return self._lgpio.gpio_read(self._handle, self.pin) == PRESSED_LEVEL
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
