chankrrn/WRO-FE-YBR-SUNFLOWER/(commit log)

2026-10-21 [INTERNATIONAL] Revise the current file and folder path, make new 3 README files and draft structure for elec.md
2026-10-22 Add 29 Visualizations with c files by matlab, wiring diagram, and restruct elec.md structure.
2026-10-22 Fix I²C to I2C formatting in documentation
2026-10-23 Replace a new wiring diagram.
2026-10-28 Add schematic diagram with 3 sheets.
2026-10-29 Replace the modular power architecture block diagram with new .png file.
2026-10-29 Update the elec.md file and replace the modular power architecture png file.
2026-10-30 Update elec.md
    Updated electrical journal to clarify scope, revise section titles, and improve documentation of MATLAB figures and sensor selection rationale.
2026-11-02 Update Raspberry Pi code with parking, lidar and motor changes
2026-11-05 Add CAD files and robot related pictures.
2026-11-07 Update Quick Wire Connector references in build guide
    Updated references for Quick Wire Connectors from D4 and D1-30 to CT-214 and D1-3 throughout the document, ensuring consistency in wiring instructions.
2026-11-12 modified: src/Raspberrypi/classes/board_manager.py modified: src/Raspberrypi/tasks/final/config.toml modified: src/Raspberrypi/tasks/path_task.py modified: src/Raspberrypi/tasks/qualification/config.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
2026-11-12 modified: src/Raspberrypi/camera_manager.py modified: src/Raspberrypi/classes/block_map.py modified: src/Raspberrypi/classes/lidar_manager.py modified: src/Raspberrypi/classes/navigation_manager.py m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
2026-11-12 modified: src/Raspberrypi/camera_manager.py deleted: src/Raspberrypi/classes/bay_park.py modified: src/Raspberrypi/classes/block_map.py modified: src/Raspberrypi/classes/lidar_manager.py modified: sr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
